mstfozkan/System-Control-Unit/ELEKTRONIK/BOM/PumpSystem BOM LIST.xlsx

Quantity | Designator | Description | Manufacturer Part Number | Fitted
51 | C1, C2, C4, C6, C7, C8, C9, C10, C11, C16, C17, C18, C19, C20, C21, C24, C25, C26, C51, C52, C53, C54, C55, C56, C57, C58, C59, C67, C68, C70, C71, C73, C75, C77, C79, C80, C83, C84, C85, C87, C88, C90, C91, C92, C93, C94, C95, C102, C112, C125, C126 | CAP CER 0.1UF 50V X7R 0603 | C1608X7R1H104K080AA | Fitted
4 | C3, C5, C32, C33 | CAP CER 4.7UF 100V X7S 1210 | HMK325C7475KM-PE | Fitted
2 | C12, C13 | CAP CER 12PF 50V C0G/NP0 0603 | CL10C120JB8NNNC | Fitted
6 | C14, C15, C22, C23, C38, C39 | CAP CER 22UF 25V X7R 1210 | CL32B226KAJNNNE | Fitted
2 | C27, C124 | CAP CER 22PF 50V C0G/NP0 0603 | CL10C220JB8NNNC | Fitted
4 | C28, C29, C122, C123 | CAP CER 0.022UF 50V X7R 0603L | CC0603KRX7R9BB223 | Fitted
5 | C30, C31, C37, C40, C41 | CAP CER 2.2UF 100V X7R 1210 | CL32B225KCJSNNE | Fitted
1 | C34 | CAP ALUM 100UF 20% 50V SMD | UUD1H101MNL1GS | Fitted
4 | C35, C36, C60, C64 | CAP CER 10UF 50V X7R 1210 | CL32B106KBJNNNE | Fitted
1 | C42 | CAP CER 3300PF 100V X7R 0603 | CGA3E2X7R2A332K080AA | Fitted
8 | C43, C44, C45, C46, C47, C48, C49, C50 | CAP CER 10UF 16V X6S 0603 | GRM188C81C106MA73D | Fitted
2 | C61, C65 | CAP CER 1UF 100V X7R 1206 | CL31B105KCHNNNE | Fitted
8 | C62, C63, C69, C74, C76, C78, C86, C89 | CAP CER 1UF 50V X7R 0603 | CC0603KRX7R9BB105 | Fitted
24 | C66, C72, C81, C82, C100, C101, C103, C104, C105, C106, C107, C108, C109, C110, C111, C113, C114, C115, C116, C117, C118, C119, C120, C121 | CAP CER 10000PF 100V X7R 0603 | C1608X7R2A103M080AA | Fitted
4 | C96, C97, C98, C99 | CAP CER 150PF 100V C0G/NP0 0603 | C0603C151J1GACTU | Fitted
1 | CMC1 | CMC 2.5A 2LN 1 KOHM SMD | DLW5BTM102TQ2L | Fitted
4 | D1, D3, D8, D9 | LED GREEN CLEAR 0603 SMD | LTST-C191KGKT | Fitted
2 | D2, D4 | LED RED CLEAR 0603 SMD | 150060RS75000 | Fitted
1 | D5 | DIODE ZENER 10V 500MW SOD123 | BZT52C10-7-F | Fitted
2 | D6, D7 | DIODE GEN PURP 100V 150MA SOD123 | 1N4148W-TP | Fitted
8 | FB1, FB2, FB3, FB5, FB6, FB7, FB13, FB14 | FERRITE BEAD 330 OHM 0603 1LN | BLM18PG331SN1D | Fitted
1 | FB4 | FERRITE BEAD 120 OHM 1206 1LN | HI1206P121R-10 | Fitted
4 | FB8, FB9, FB10, FB11 | FERRITE BEAD 600 OHM 0603 1LN | BLM18KG601SN1D | Fitted
1 | FB12 | FERRITE BEAD 300 OHM 1206 1LN | 742792121 | Fitted
4 | J1, J2, J10, J11 | CONN RCPT 6POS 0.1 TIN PCB | M20-7820646 | Fitted
2 | J3, J4 | WR-DSUB FEMALE ANGLED PCB CONNEC | 618009211821 | Fitted
2 | J5, J8 | TERM BLK 8P SIDE ENT 2.54MM SMD | 14010813102000 | Fitted
1 | J6 | CONN HEADER VERT 20POS 2.54MM | 302-S201 | Fitted
2 | J7, J9 | CONN PLUG FMALE 4POS GOLD SOLDER | T4145515041-001 | Fitted
1 | J12 | TERM BLK 2P SIDE ENT 2.54MM SMD | 14010213102000 | Fitted
2 | L1, L2 | FIXED IND 2.2UH 2.1A 106 MOHM | 74479299222 | Fitted
1 | L3 | FIXED IND 4.7UH 5.5A 34.5MOHM | 74438367047 | Fitted
1 | Q1 | P-channel MOSFET SOT-223 | MCT06P10-TP | Fitted
3 | Q2, Q3, Q4 | TRANS NPN 80V 0.5A SOT23 | MMBTA06LT1G | Fitted
11 | R1, R2, R14, R16, R27, R37, R38, R40, R42, R71, R72 | RES SMD 10K OHM 1% 1/10W 0603 | RC0603FR-0710KL | Fitted
6 | R3, R4, R6, R7, R63, R64 | RES 249 OHM 1% 1/10W 0603 | RMCF0603FT249R | Fitted
10 | R5, R8, R15, R17, R20, R23, R61, R62, R65, R66 | RES SMD 0 OHM 1/10W JUMP 0603 | RC0603JR-070RL | Fitted
1 | R9 | RES 100K OHM 1% 1/10W 0603 | RMCF0603FT100K | Fitted
1 | R10 | RES 200K OHM 1% 1/10W 0603 | RMCF0603FT200K | Fitted
3 | R11, R24, R41 | RES 250 OHM 0.01% 1/10W 0603 | RNCF0603TKY250R | Fitted
1 | R12 | RES SMD 22K OHM 1% 1/8W 0603 | MCT06030C2202FP500 | Fitted
3 | R13, R44, R46 | RES 69.8K OHM 1% 1/10W 0603 | RMCF0603FT69K8 | Fitted
3 | R18, R33, R35 | RES SMD 100 OHM 1% 1/8W 0603 | RNCP0603FTD100R | Fitted
9 | R19, R21, R26, R28, R31, R32, R34, R69, R70 | RES SMD 1K OHM 5% 1/10W 0603 | RC0603JR-071KL | Fitted
4 | R22, R39, R43, R45 | RES SMD 5.11KOHM 0.1% 1/10W 0603 | ERA-3AEB5111V | Fitted
1 | R25 | RES 27.4K OHM 1% 1/10W 0603 | RMCF0603FT27K4 | Fitted
2 | R29, R36 | RES SMD 470 OHM 5% 1/10W 0603 | RC0603JR-07470RL | Fitted
1 | R30 | RES SMD 0 OHM 1/10W JUMP 0603 | RC0603JR-070RL | Fitted
8 | R47, R48, R49, R50, R51, R52, R53, R54 | RES SMD 75 OHM 1% 1/10W 0603 | RMCF0603FT75R0 | Fitted
4 | R55, R56, R57, R58 | RES 51 OHM 1% 1/10W 0603 | RMCF0603FT51R0 | Fitted
2 | R59, R60 | RES SMD 100K OHM 5% 1/10W 0603 | RC0603JR-10100KL | Fitted
2 | R67, R68 | RES SMD 330 OHM 5% 1/10W 0603 | RC0603JR-07330RL | Fitted
2 | SW1, SW2 | SWITCH SLIDE DPDT 100MA 12V | AYZ0202AGRLC | Fitted
2 | SW3, SW4 | SWITCH TACTILE SPST-NO 0.05A 24V | FSM4JSMA | Fitted
4 | T1, T2, T3, T4 | WE-RJ45 LAN INTEGRATED RJ45 TRANS | 74980104400 | Fitted
2 | TVS1, TVS30 | DIODE TVS 33VWM 53.3VC SMB | SMBJ33CA | Fitted
4 | TVS2, TVS4, TVS5, TVS7 | TVS DIODE 15V 24.4V DO214AC | SMAJ15CA | Fitted
2 | TVS3, TVS6 | TVS DIODE 15V 44V SOT23 | PESD15VL2BT,215 | Fitted
20 | TVS8, TVS9, TVS11, TVS12, TVS13, TVS14, TVS15, TVS16, TVS17, TVS18, TVS19, TVS21, TVS22, TVS23, TVS24, TVS25, TVS26, TVS27, TVS28, TVS29 | TVS DIODE 33V 53.3V DO214AC | SMAJ33CA | Fitted
8 | TVS10, TVS20, TVS31, TVS32, TVS33, TVS34, TVS35, TVS36 | TVS DIODE 5.5V 12.4V SC70-3 | TPD2E2U06QDCKRQ1 | Fitted
1 | U1 | IC MCU 32BIT 256KB FLASH 64LQFP | STM32F446RCT6TR | Fitted
1 | U2 | DCDC CONV HV BUCK SO-8EP | AP64350SP-13 | Fitted
2 | U3, U4 | IC REG LINEAR 3.3V 1.5A 8SO | AP7362A-33SP-13 | Fitted
1 | U5 | IC TRANSCEIVER FULL 2/2 16TSSOP | TRS3232ECPWR | Fitted
2 | U6, U7 | IC TRANSCEIVER 1/1 10VSON | TIOL111DMWR | Fitted
1 | U8 | IC OPAMP GP 2 CIRCUIT 8SOIC | LM2904BQDRQ1 | Fitted
1 | U9 | IC ADC 24BIT SIGMA-DELTA 32LFCSP | AD7124-8BCPZ | Fitted
1 | U10 | IC EEPROM 128K I2C 1MHZ 8SOIC | AT24C128C-SSHM-B | Fitted
1 | VR1 | VARISTOR 39V 80A 0805 | B72510E1250K62 | Fitted
1 | Y1 | CRYSTAL 16MHZ 12PF SMD | RH100-16.000-12-3050-EX | Fitted
1 | Y2 | XTAL OSC XO 2.4576MHZ CMOS SMD | SG-210STF 2.4576ML | Fitted
