mstfozkan/System-Control-Unit/DOKUMANLAR/Schematic.PDF

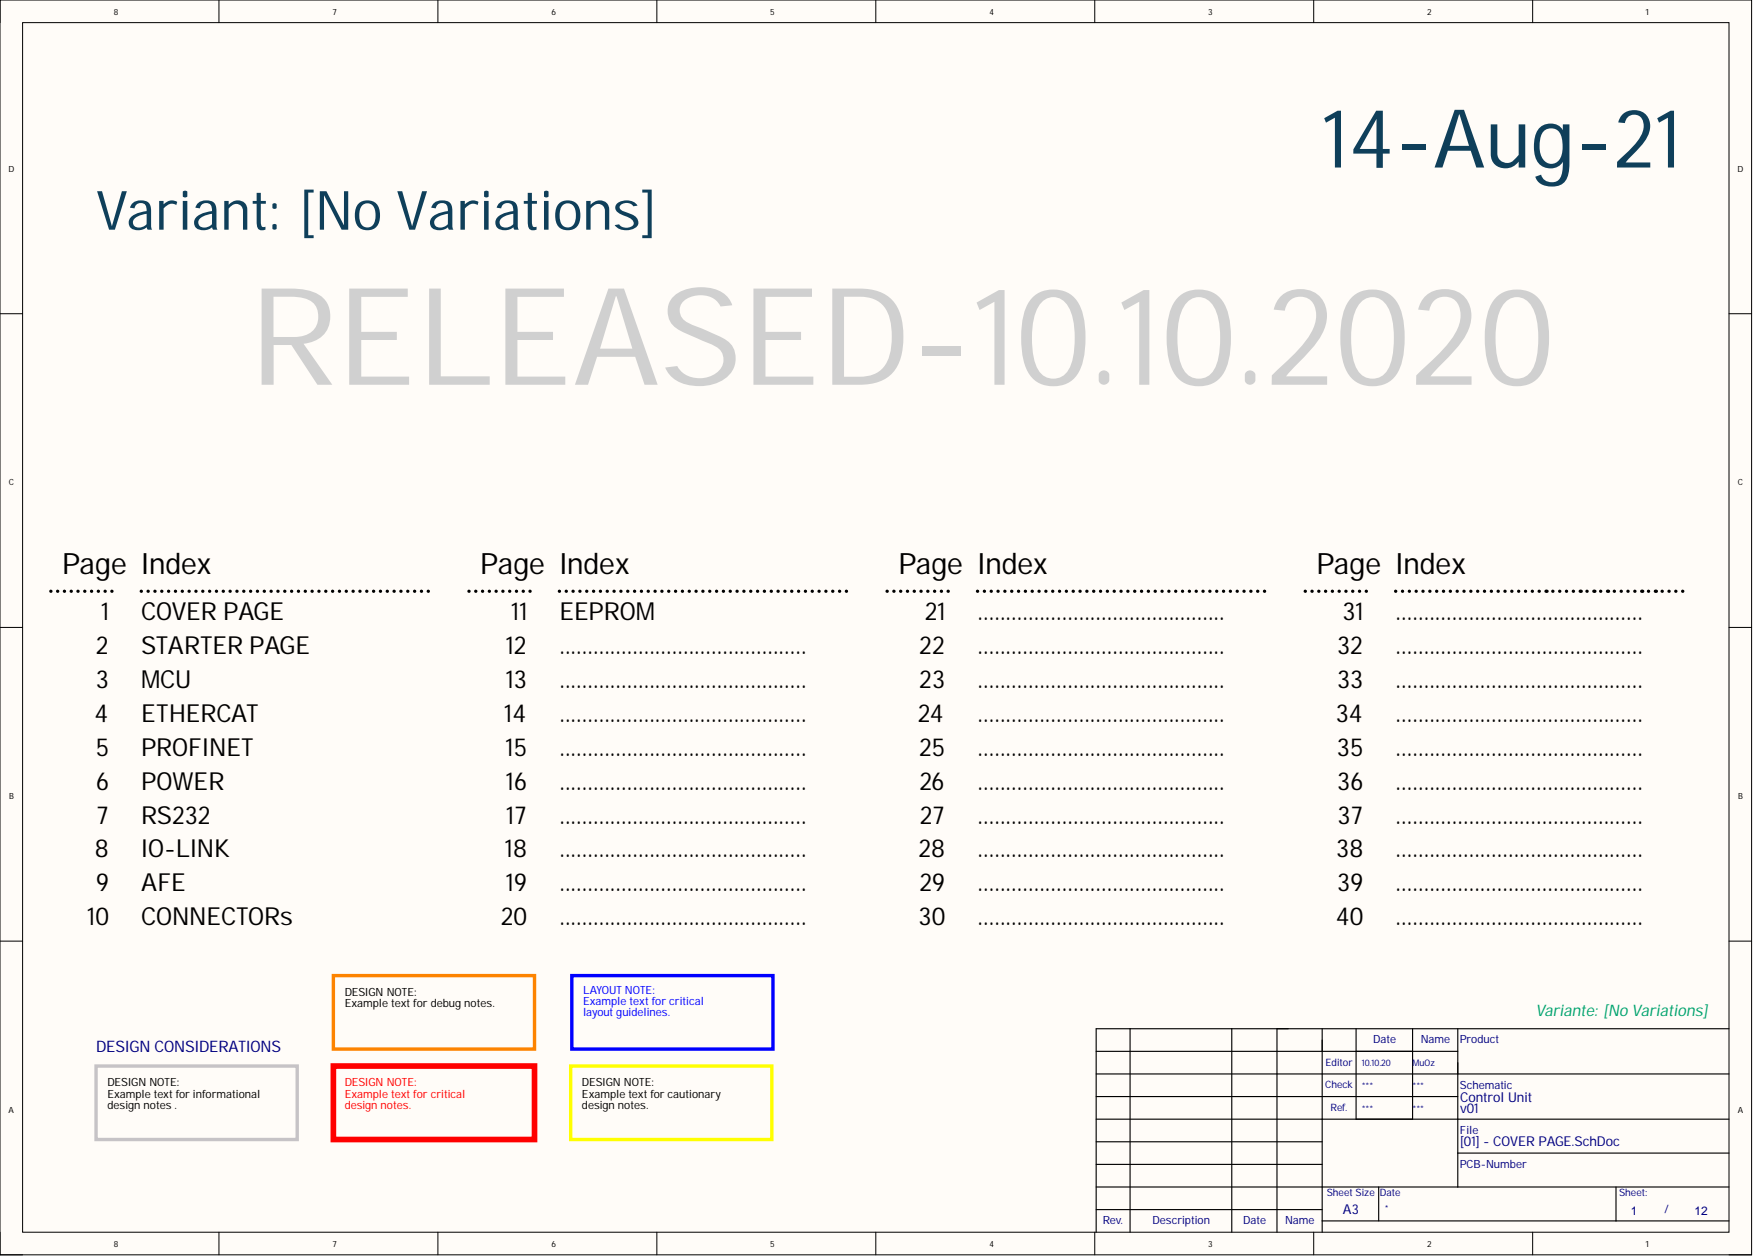
[picture p1: page 1]

DESIGN NOTE:
Example text for debug notes.

LAYOUT NOTE:
Example text for critical
layout guidelines.

Example text for informational
design notes .

design notes.

Example text for cautionary

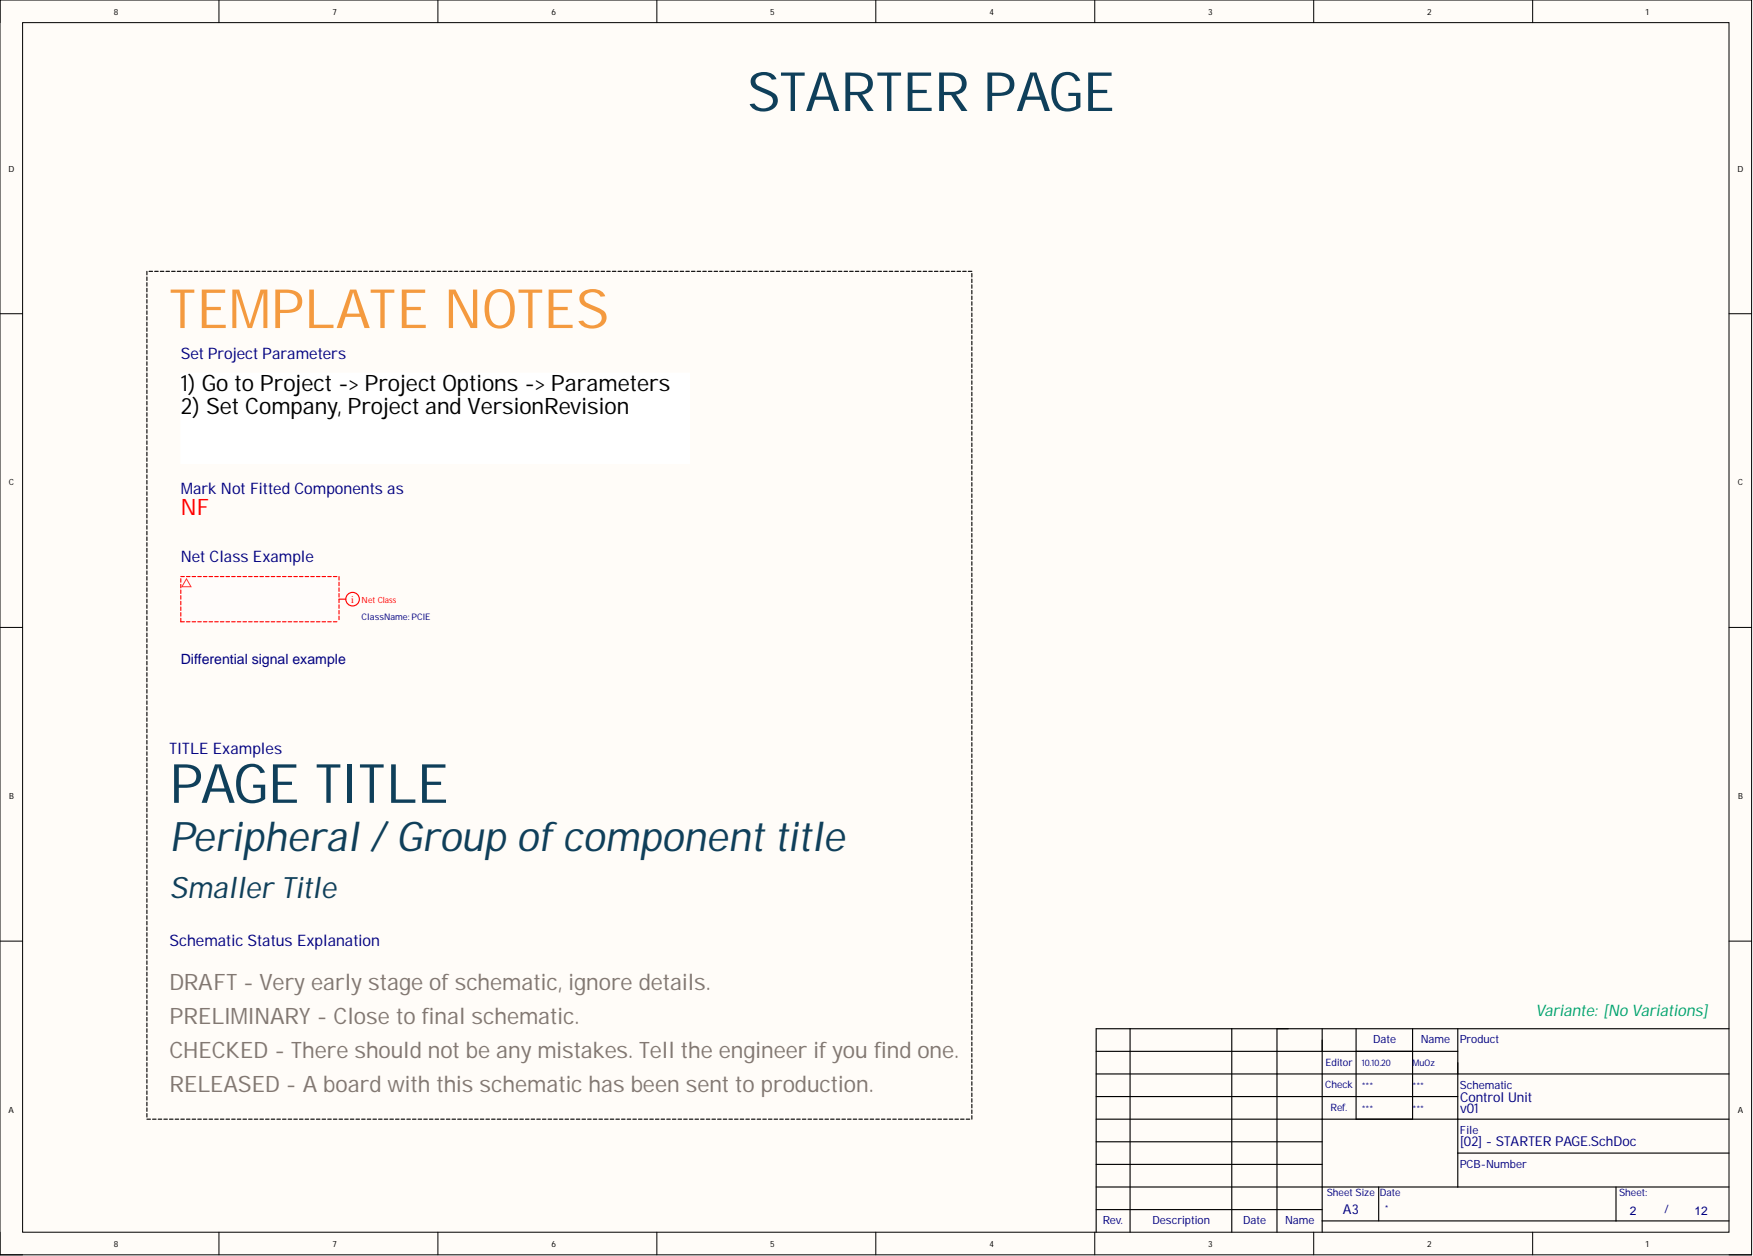
[picture p2: page 2]

Set Project Parameters
1) Go to Project -> Project Options -> Parameters
2) Set Company, Project and VersionRevision

Mark Not Fitted Components as

TITLE Examples
PAGE TITLE
Peripheral / Group of component title

Schematic Status Explanation
DRAFT - Very early stage of schematic, ignore details.
PRELIMINARY - Close to final schematic.
CHECKED - There should not be any mistakes. Tell the engineer if you find one.
RELEASED - A board with this schematic has been sent to production.

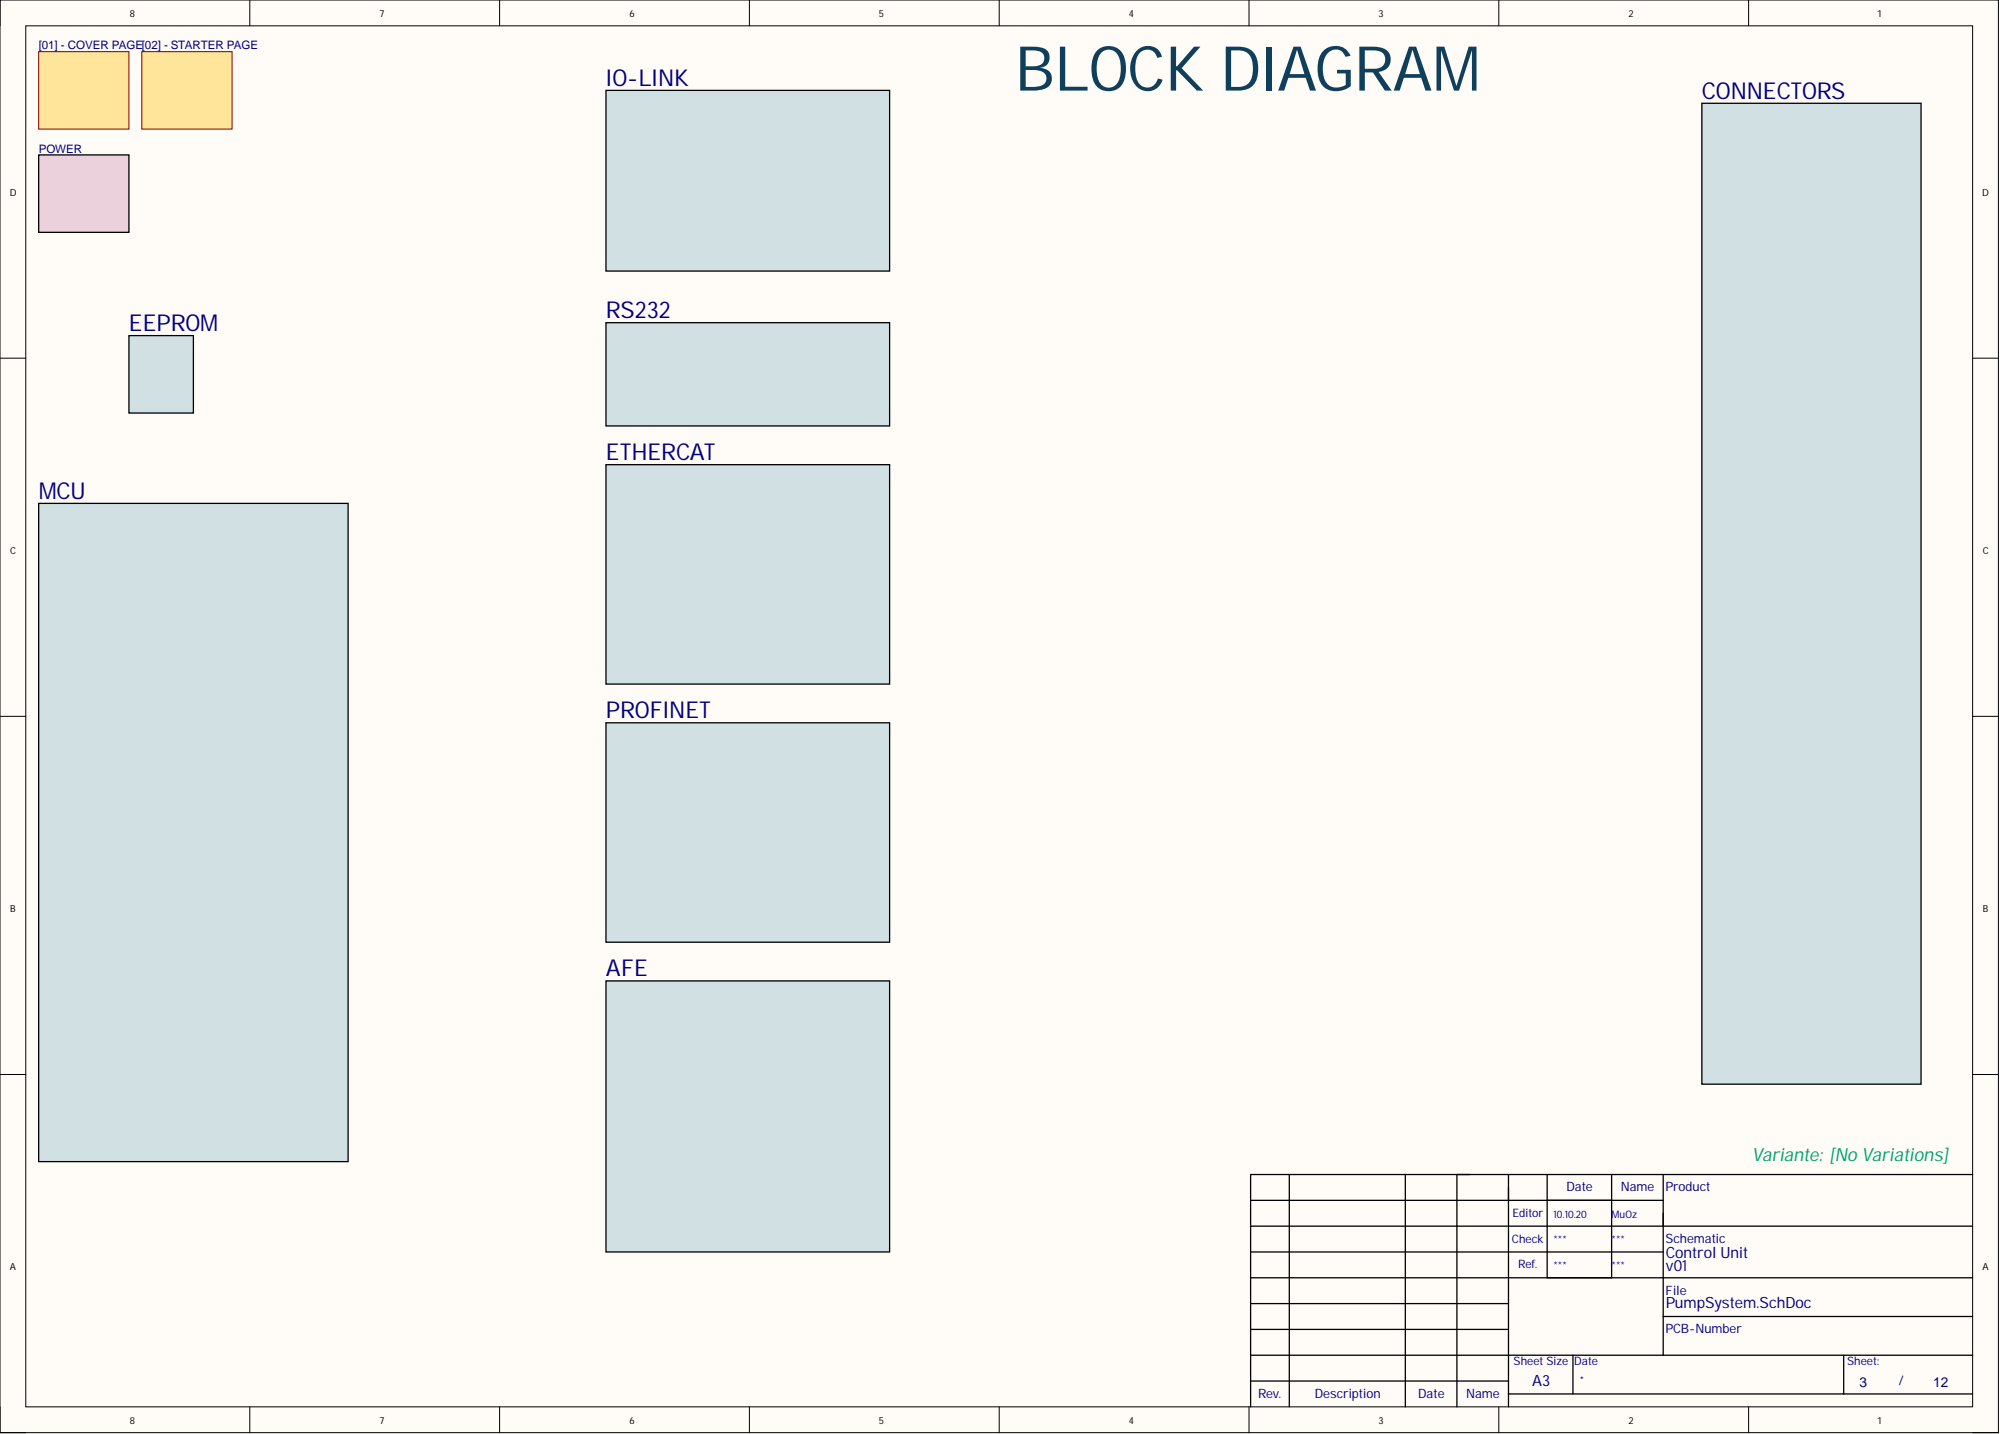
[picture p3: page 3]

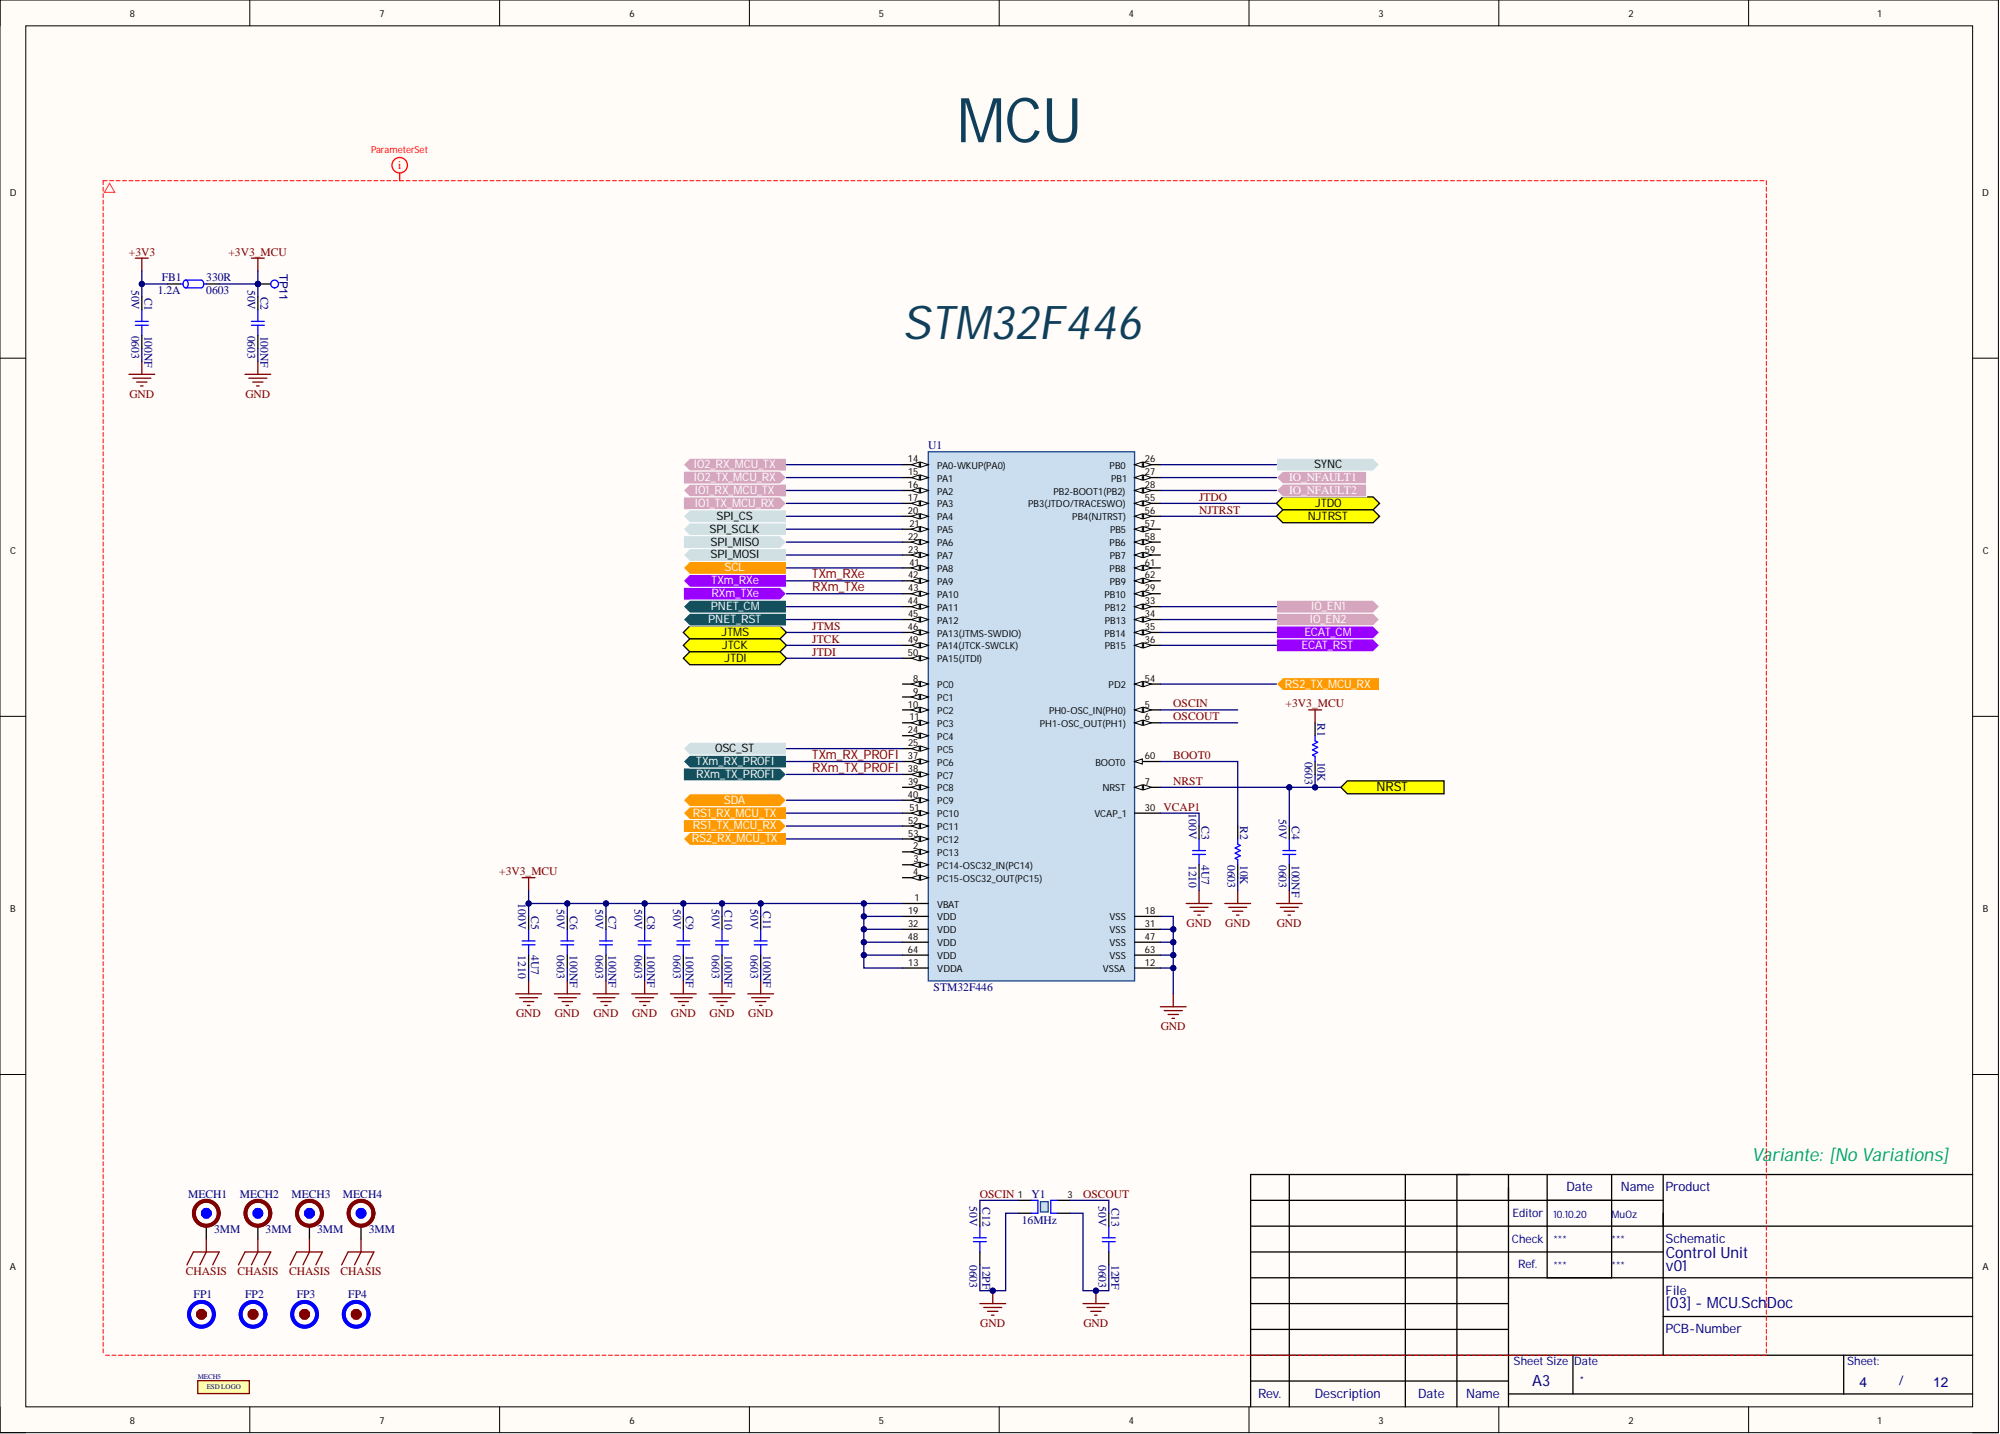
[picture p4: page 4]

CHASIS CHASIS

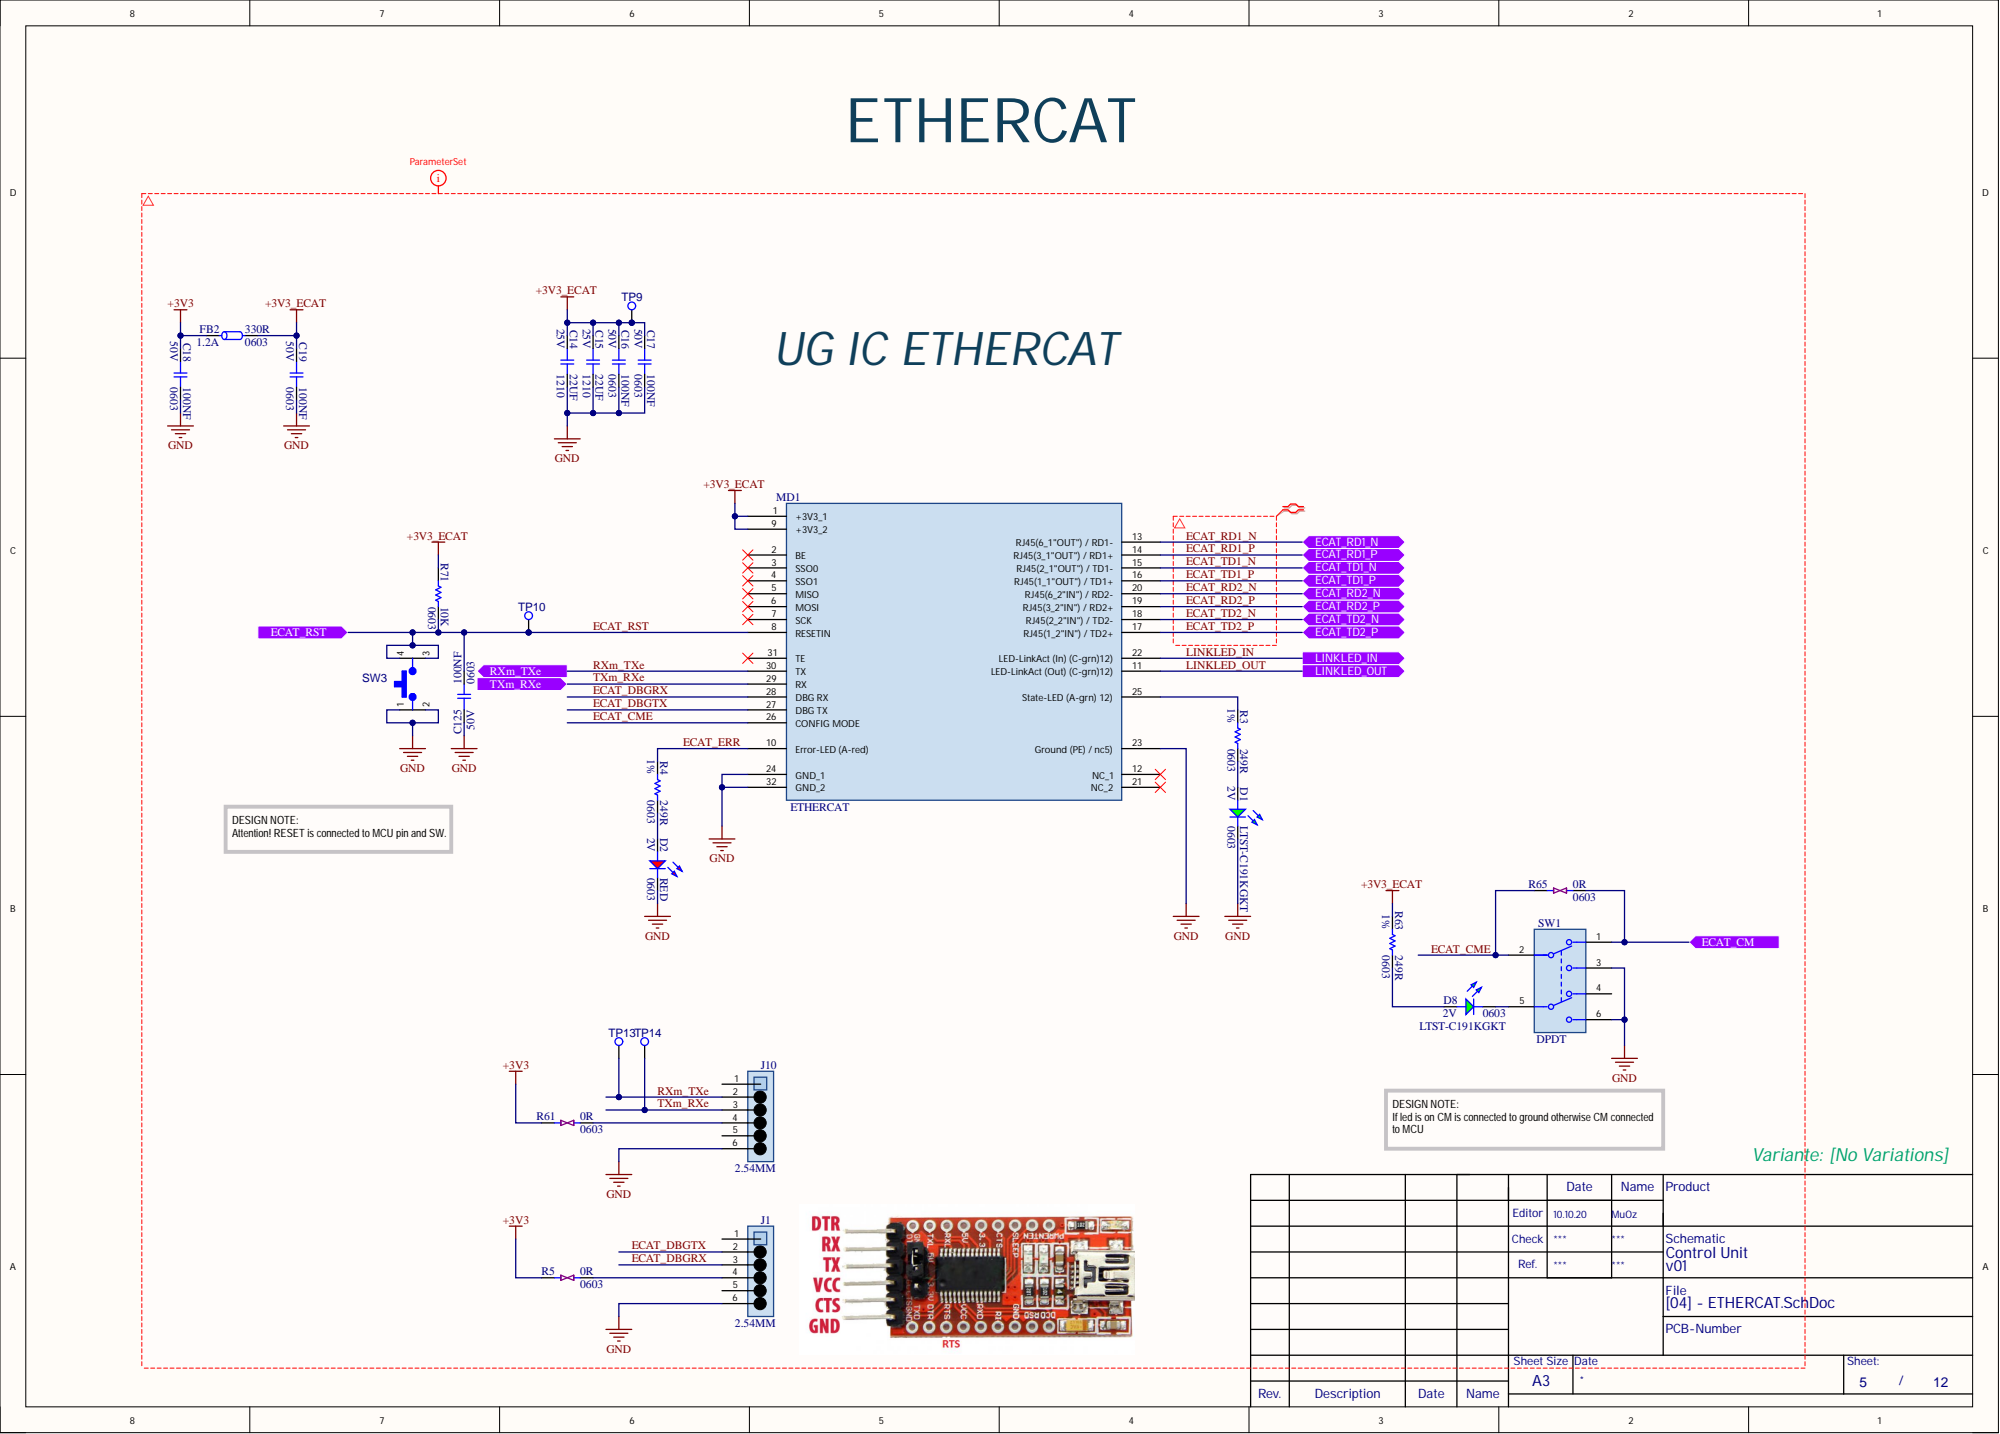
[picture p5: page 5]

DESIGN NOTE:
Attention! RESET is connected to MCU pin and SW.

If led is on CM is connected to ground otherwise CM connected
to MCU

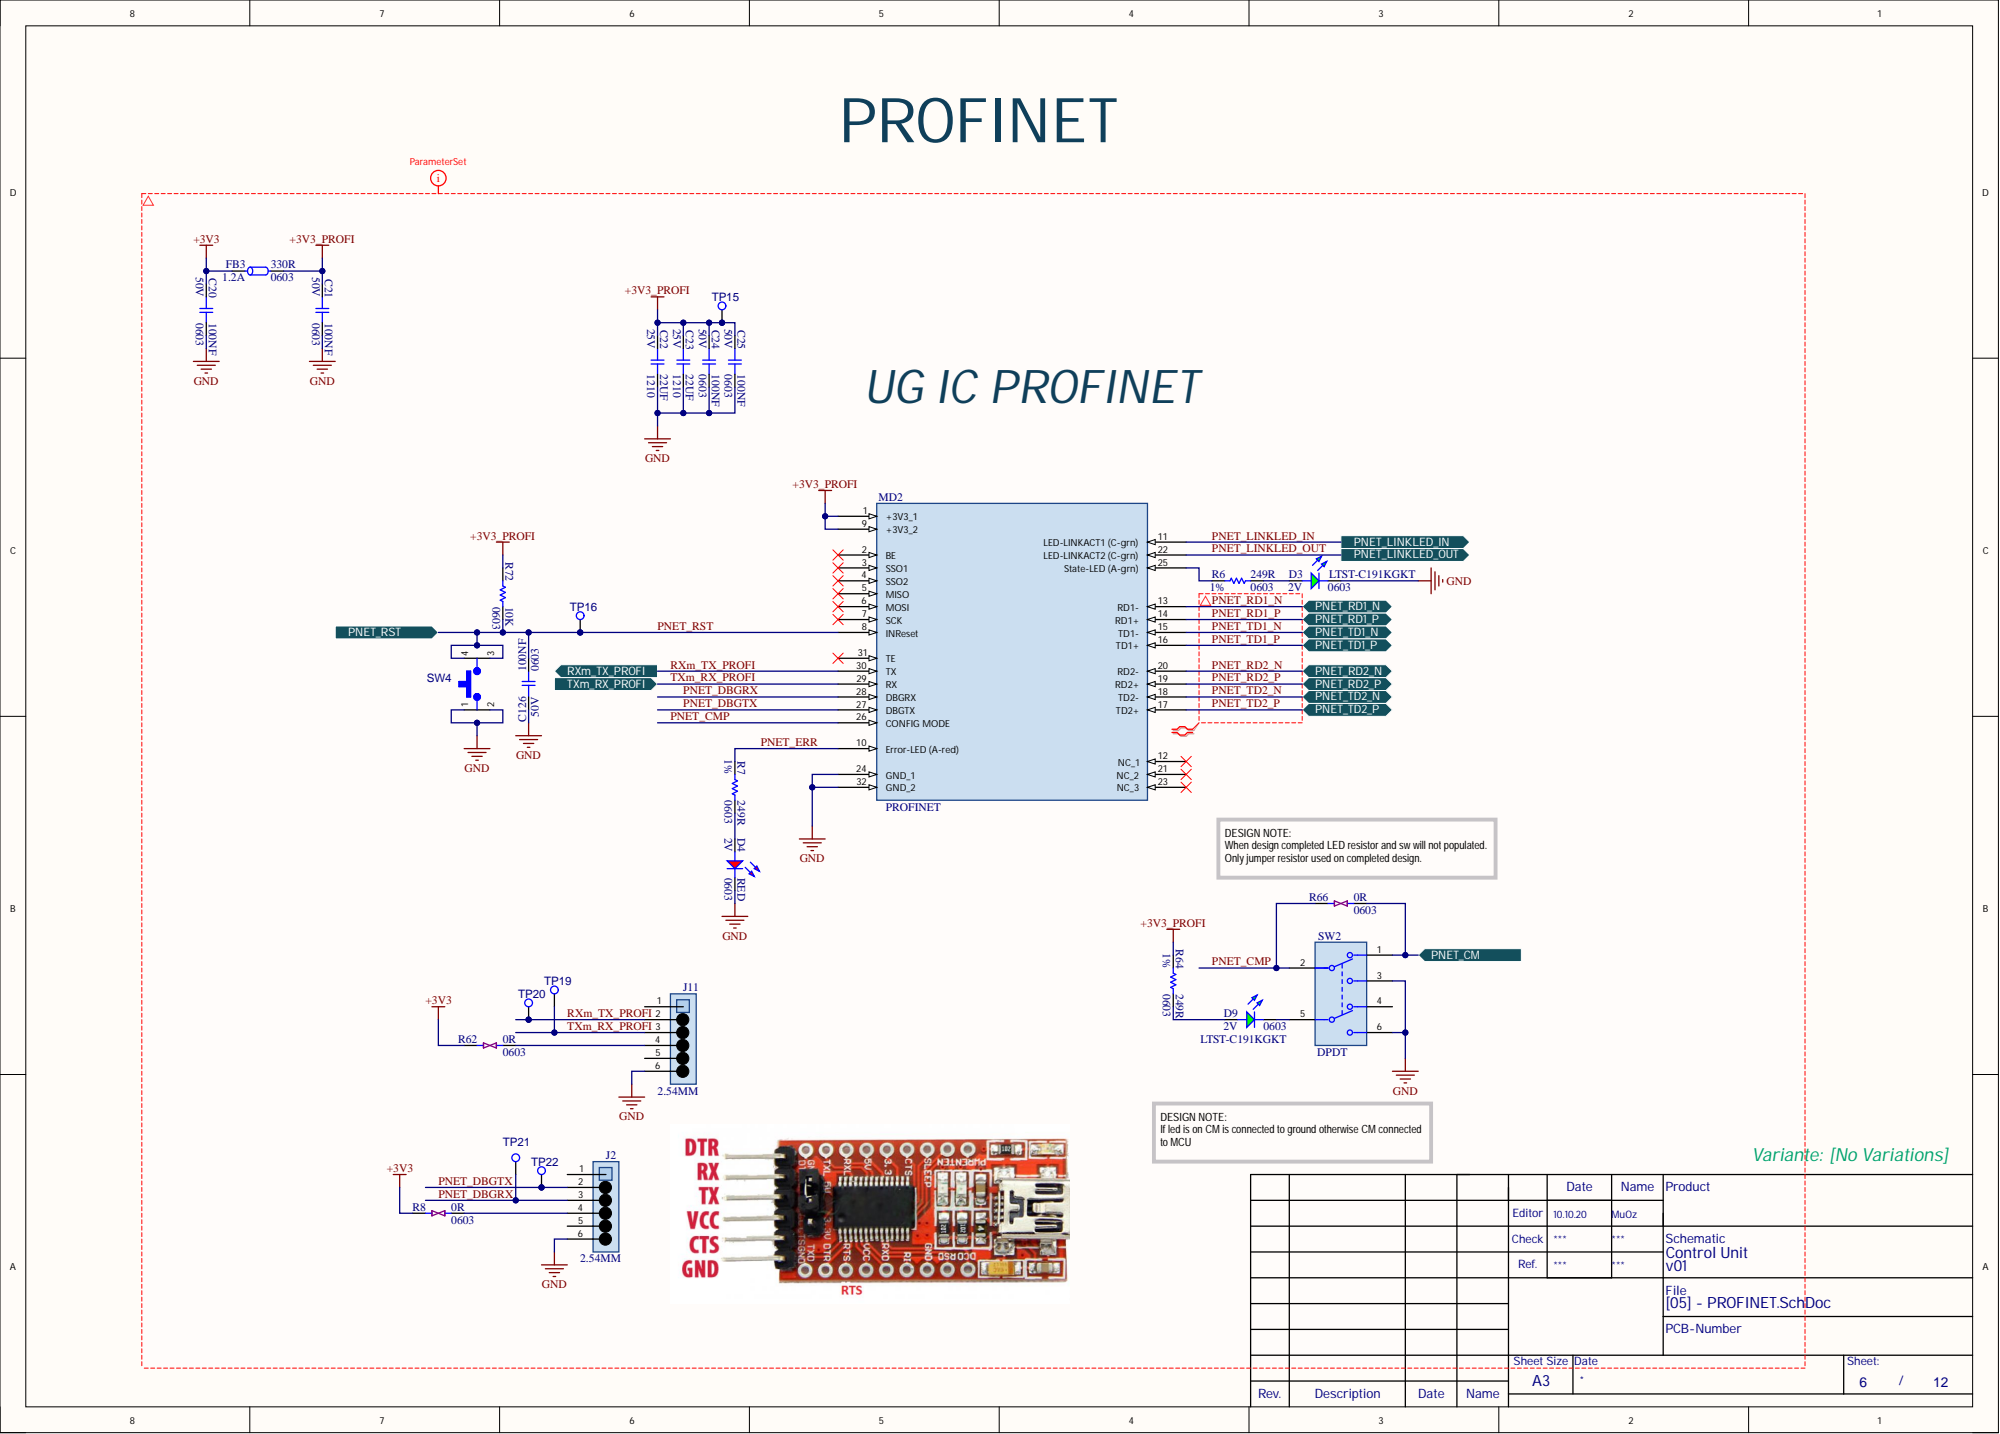
[picture p6: page 6]

DESIGN NOTE:
When design completed LED resistor and sw will not populated.
Only jumper resistor used on completed design.

If led is on CM is connected to ground otherwise CM connected
to MCU

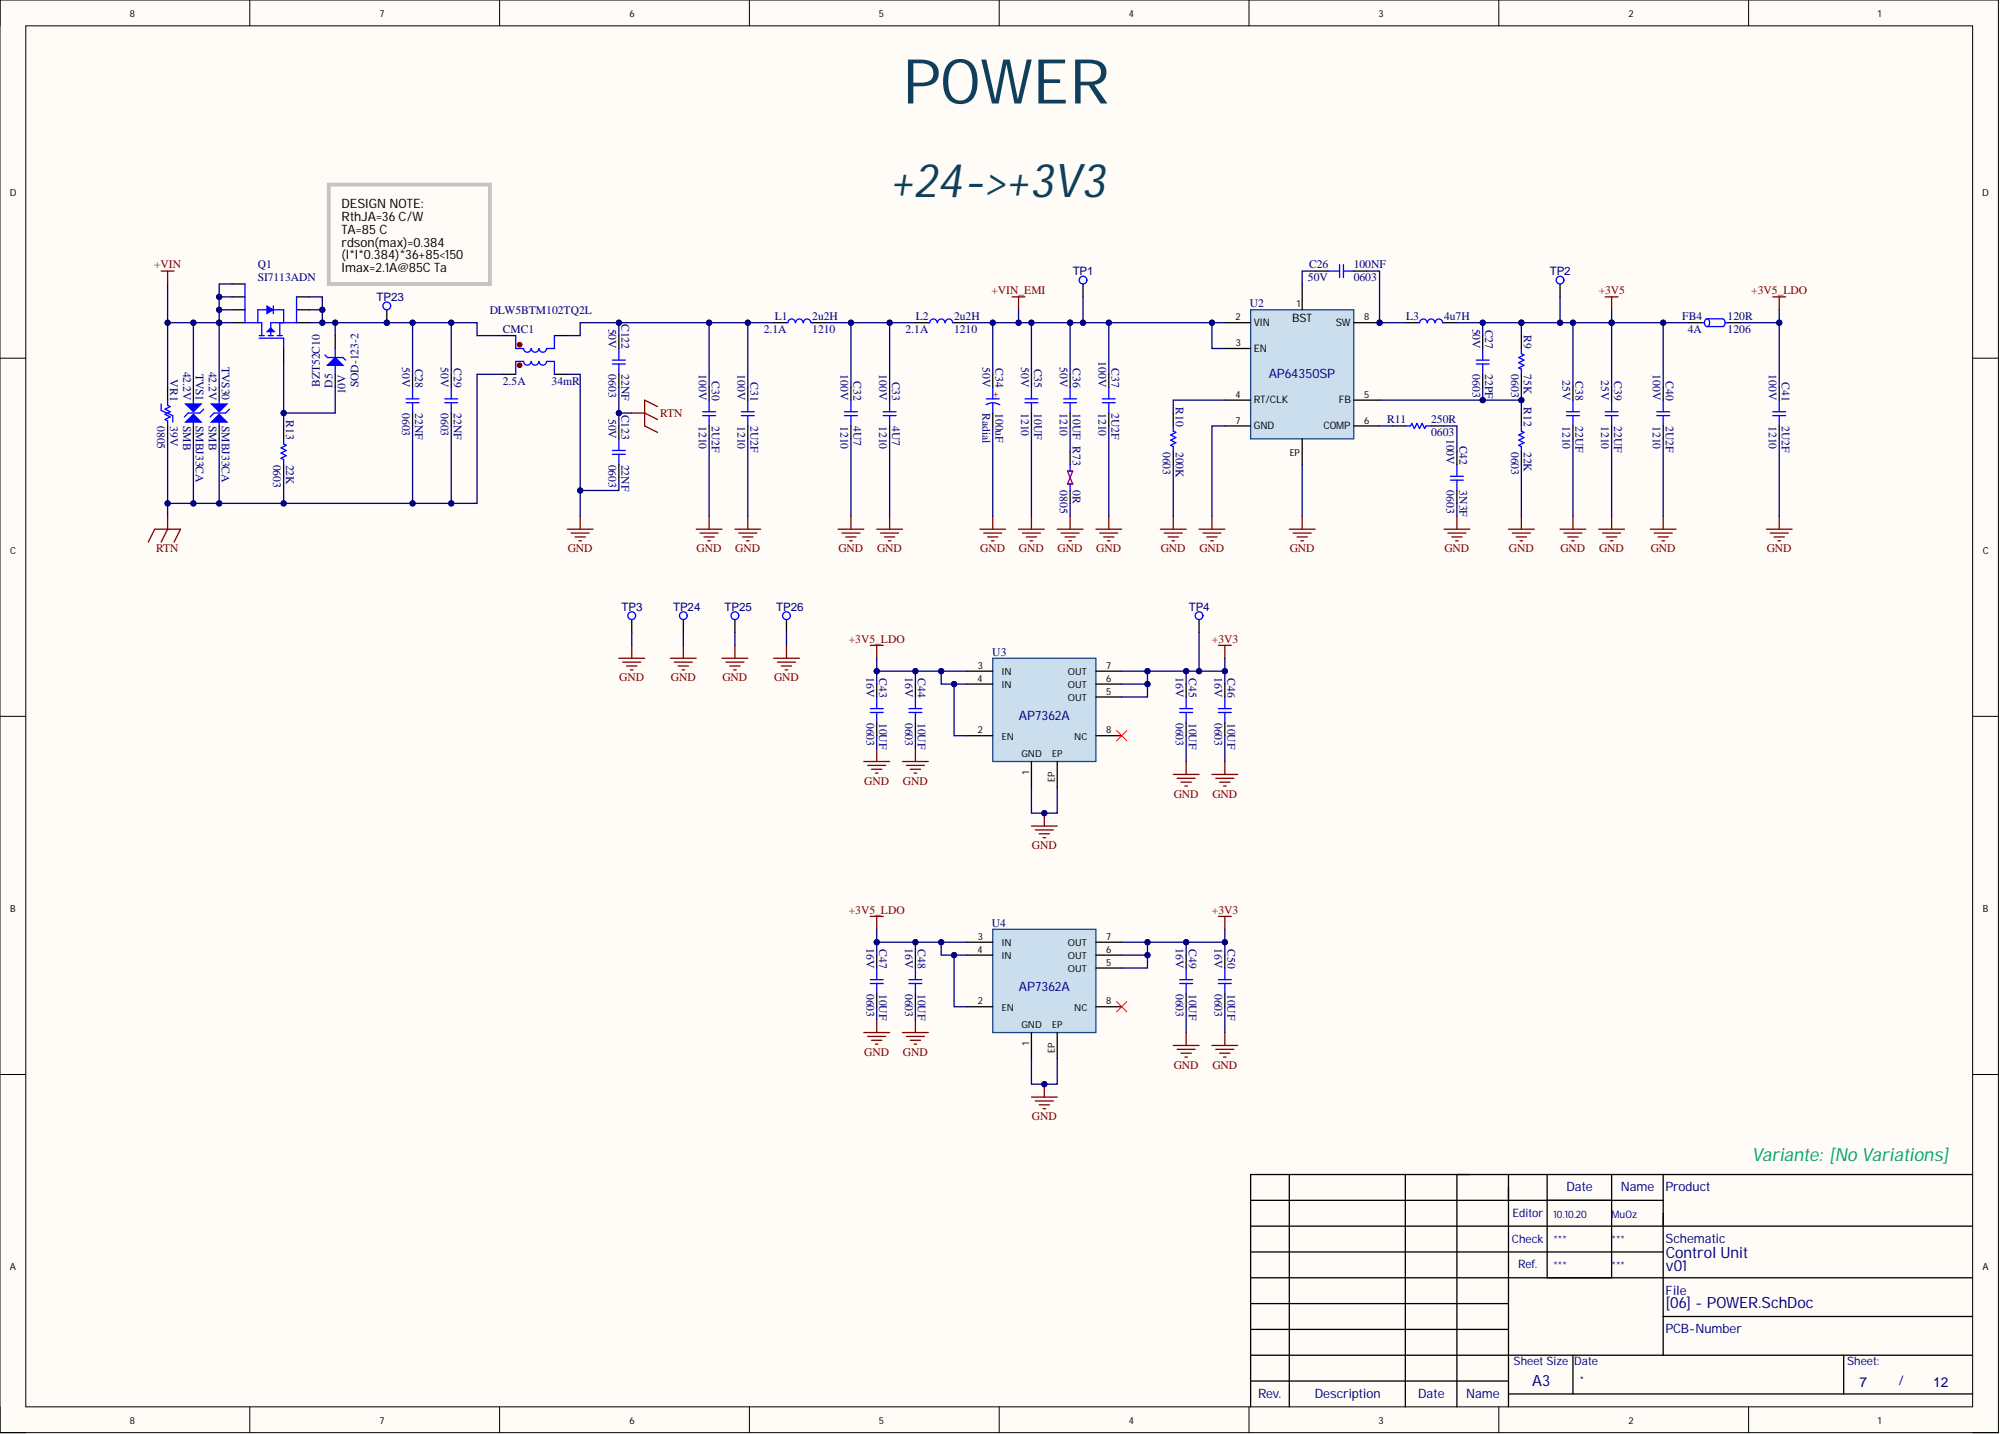
[picture p7: page 7]

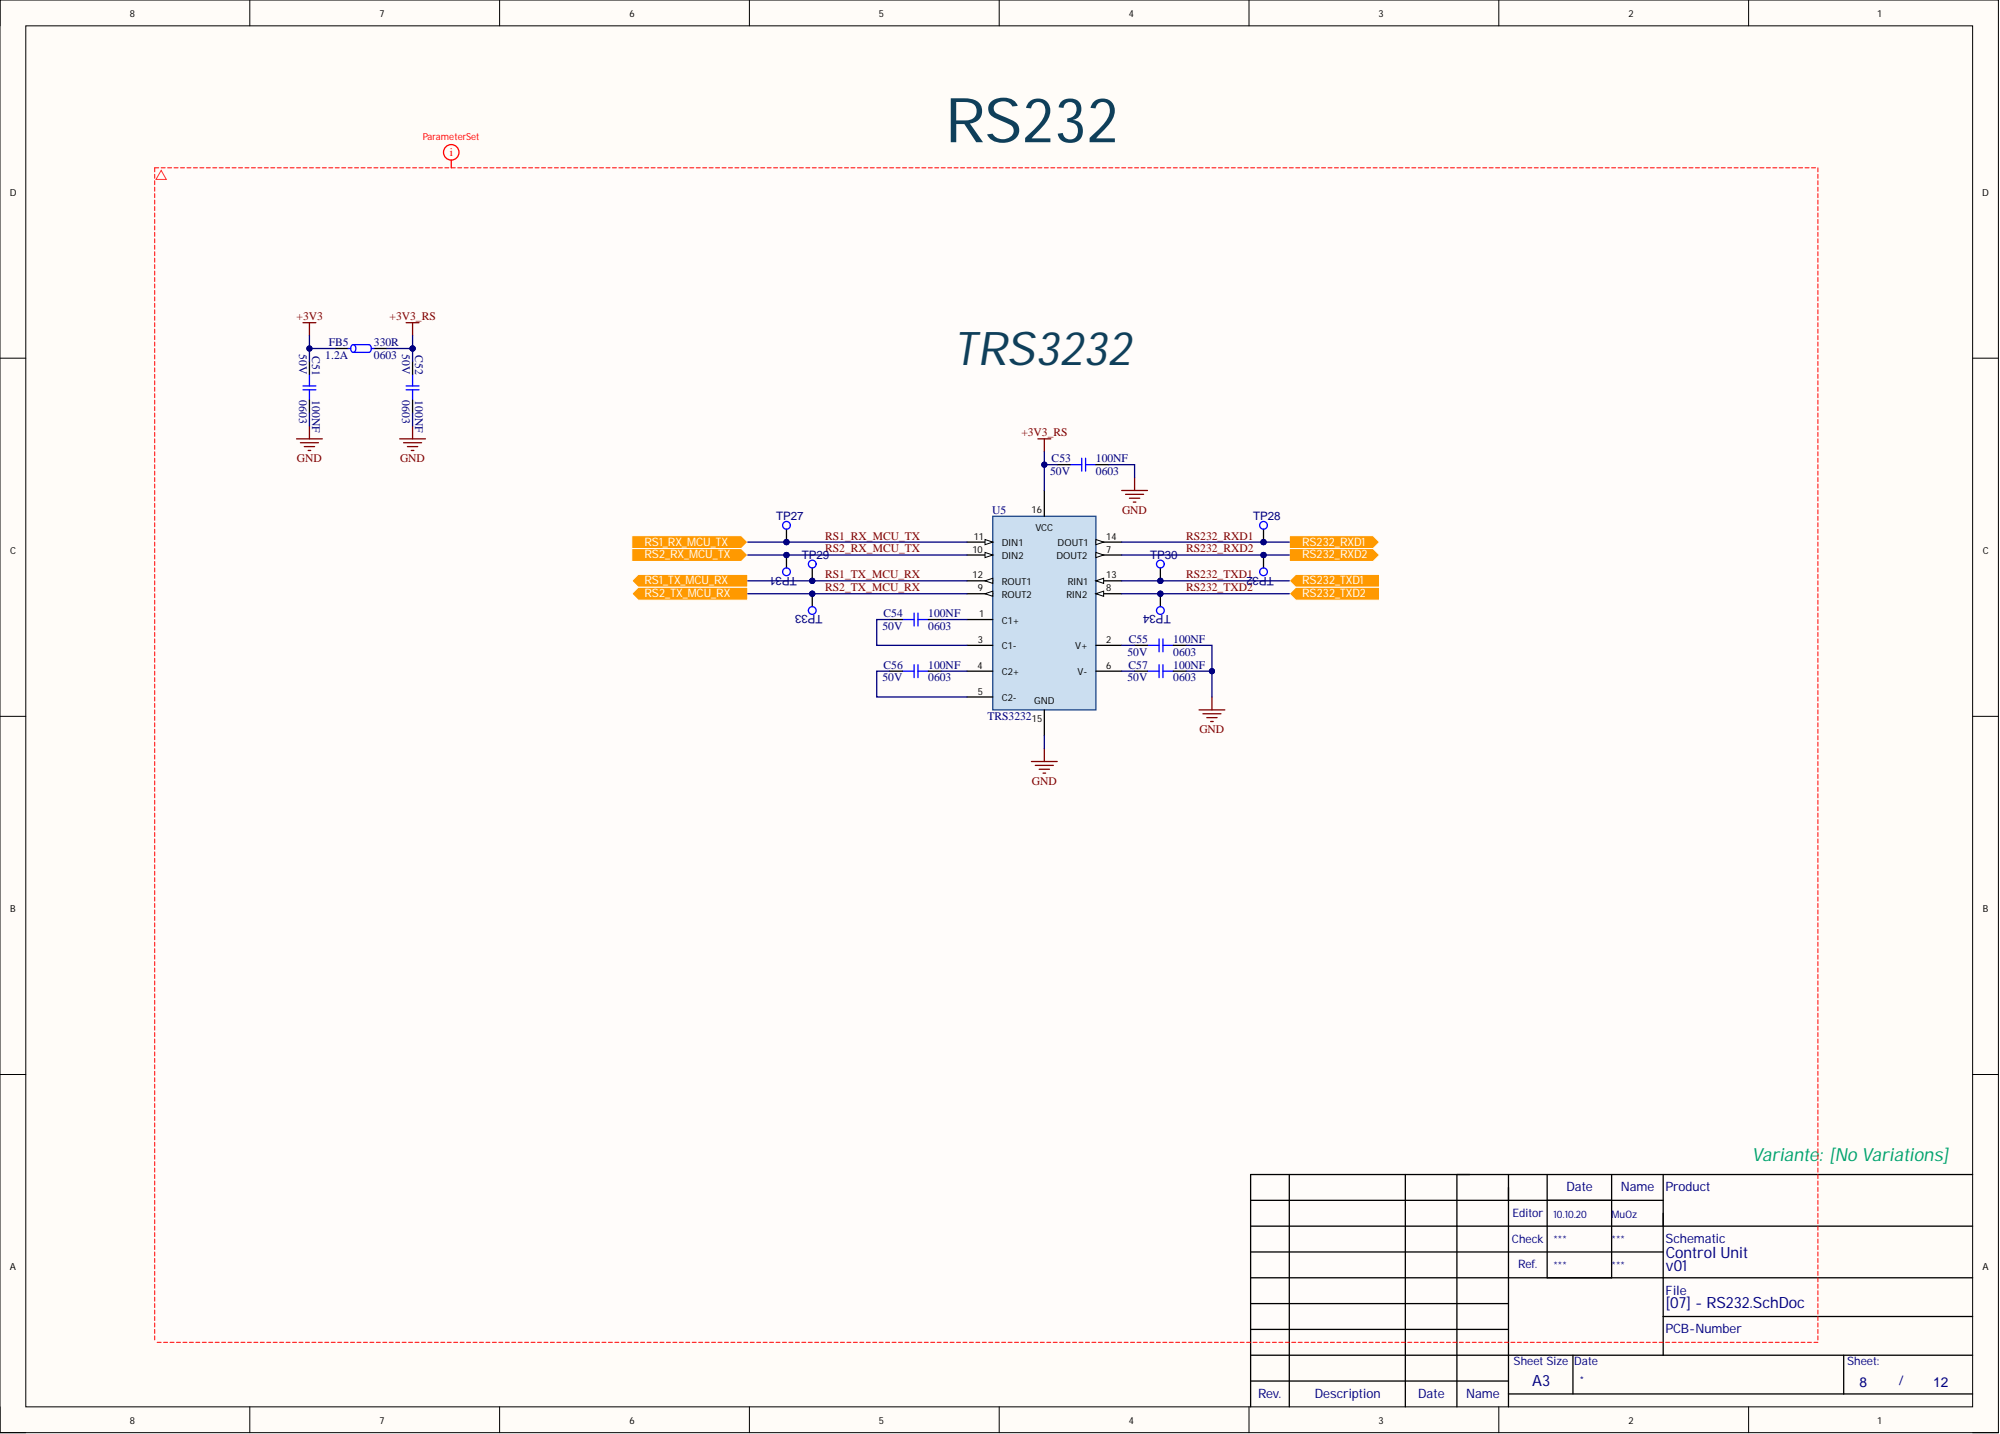
[picture p8: page 8]

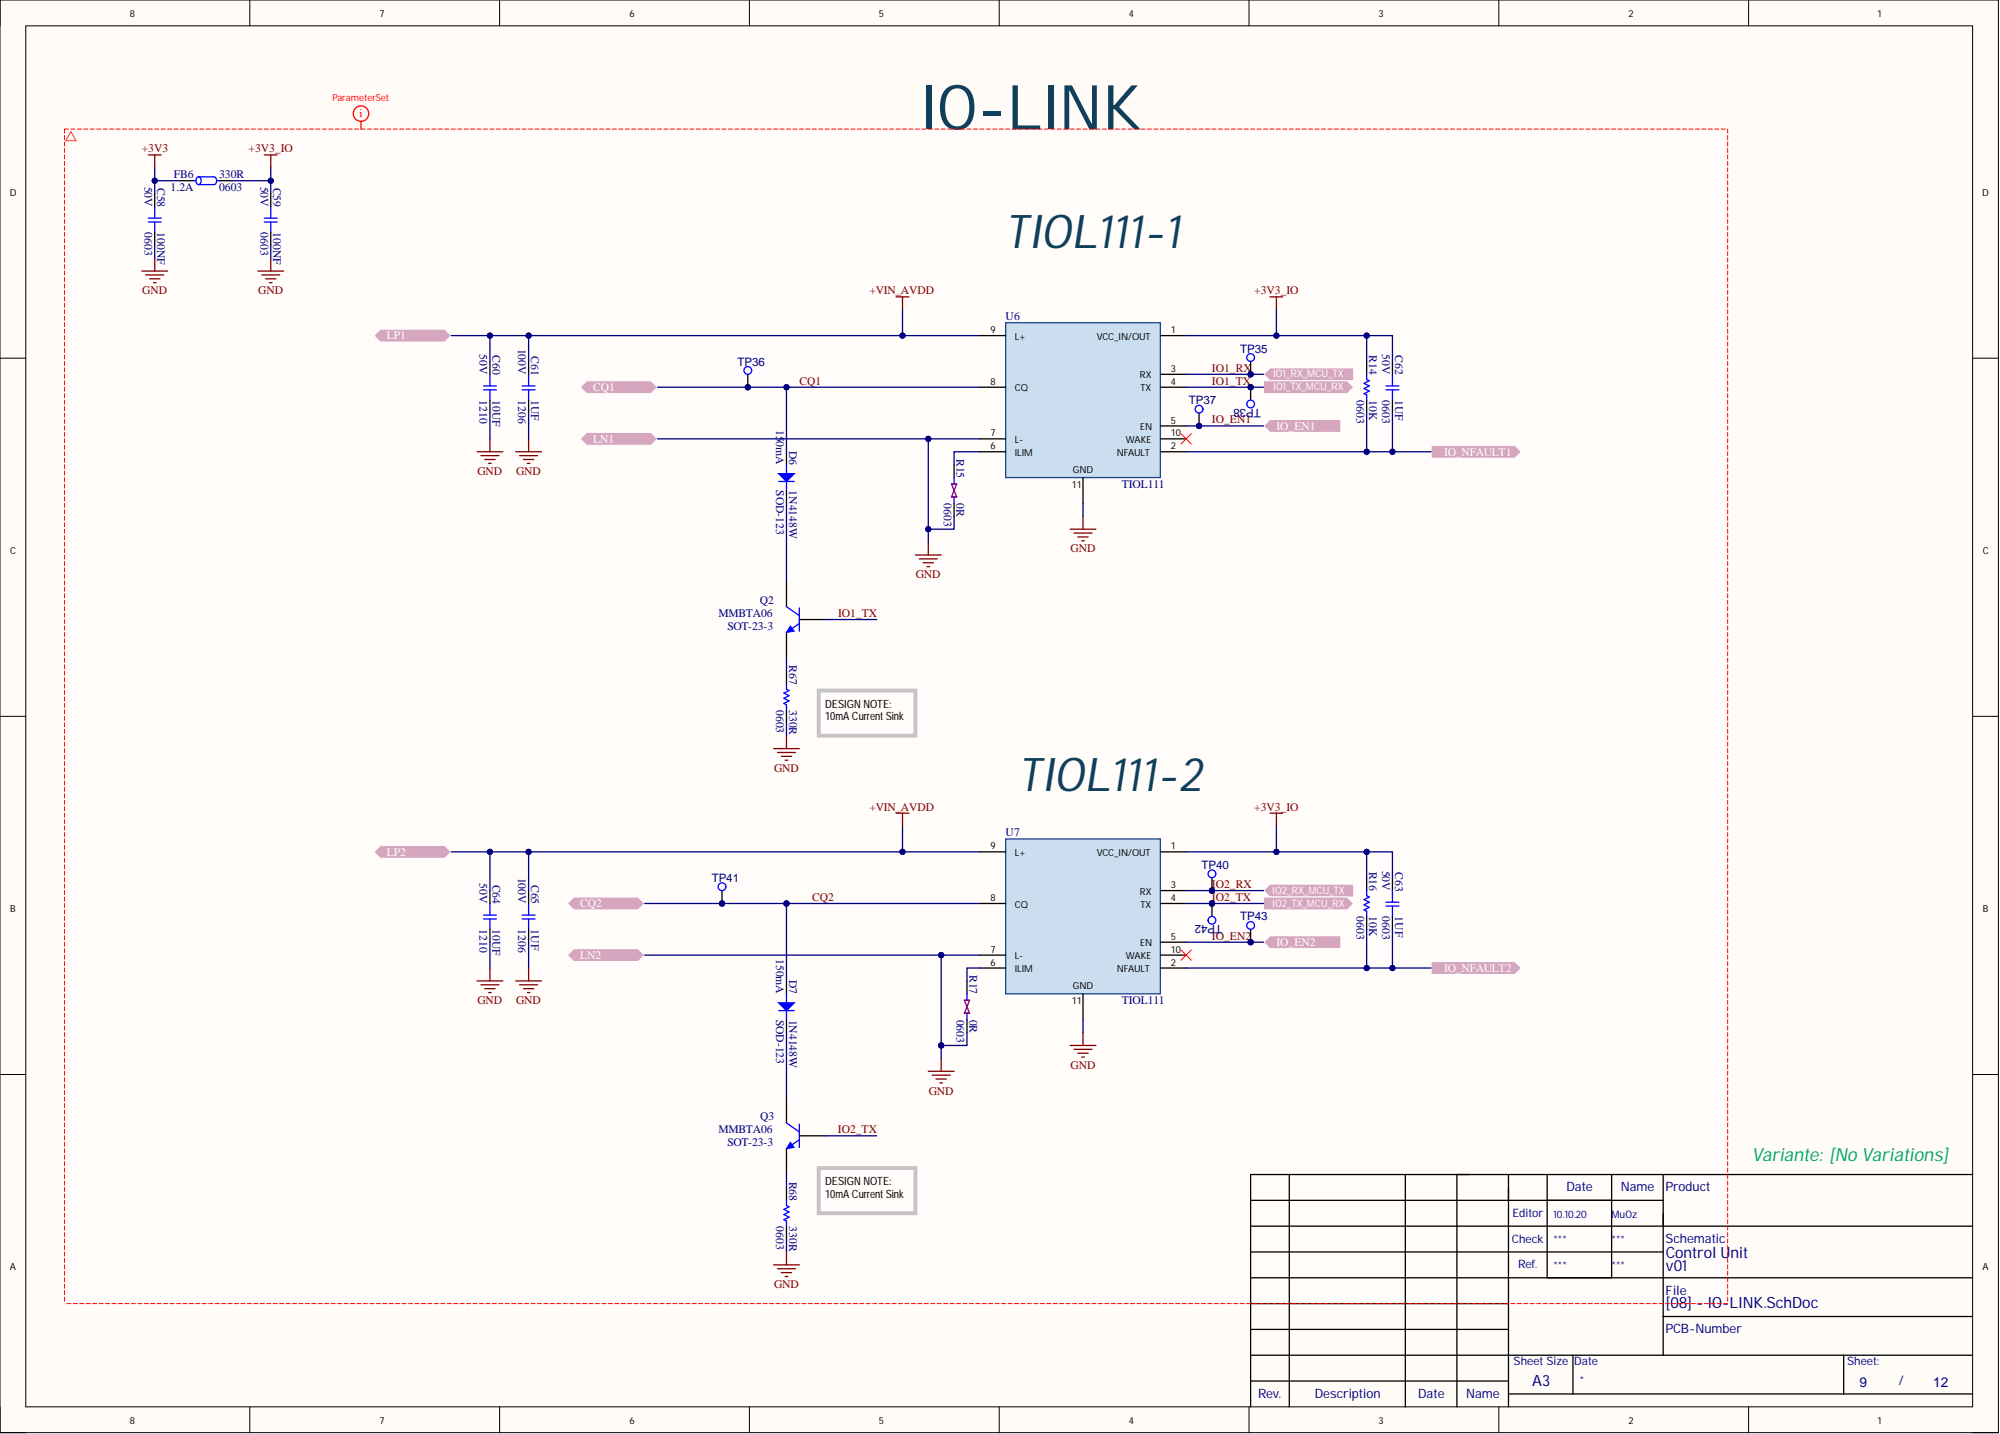
[picture p9: page 9]

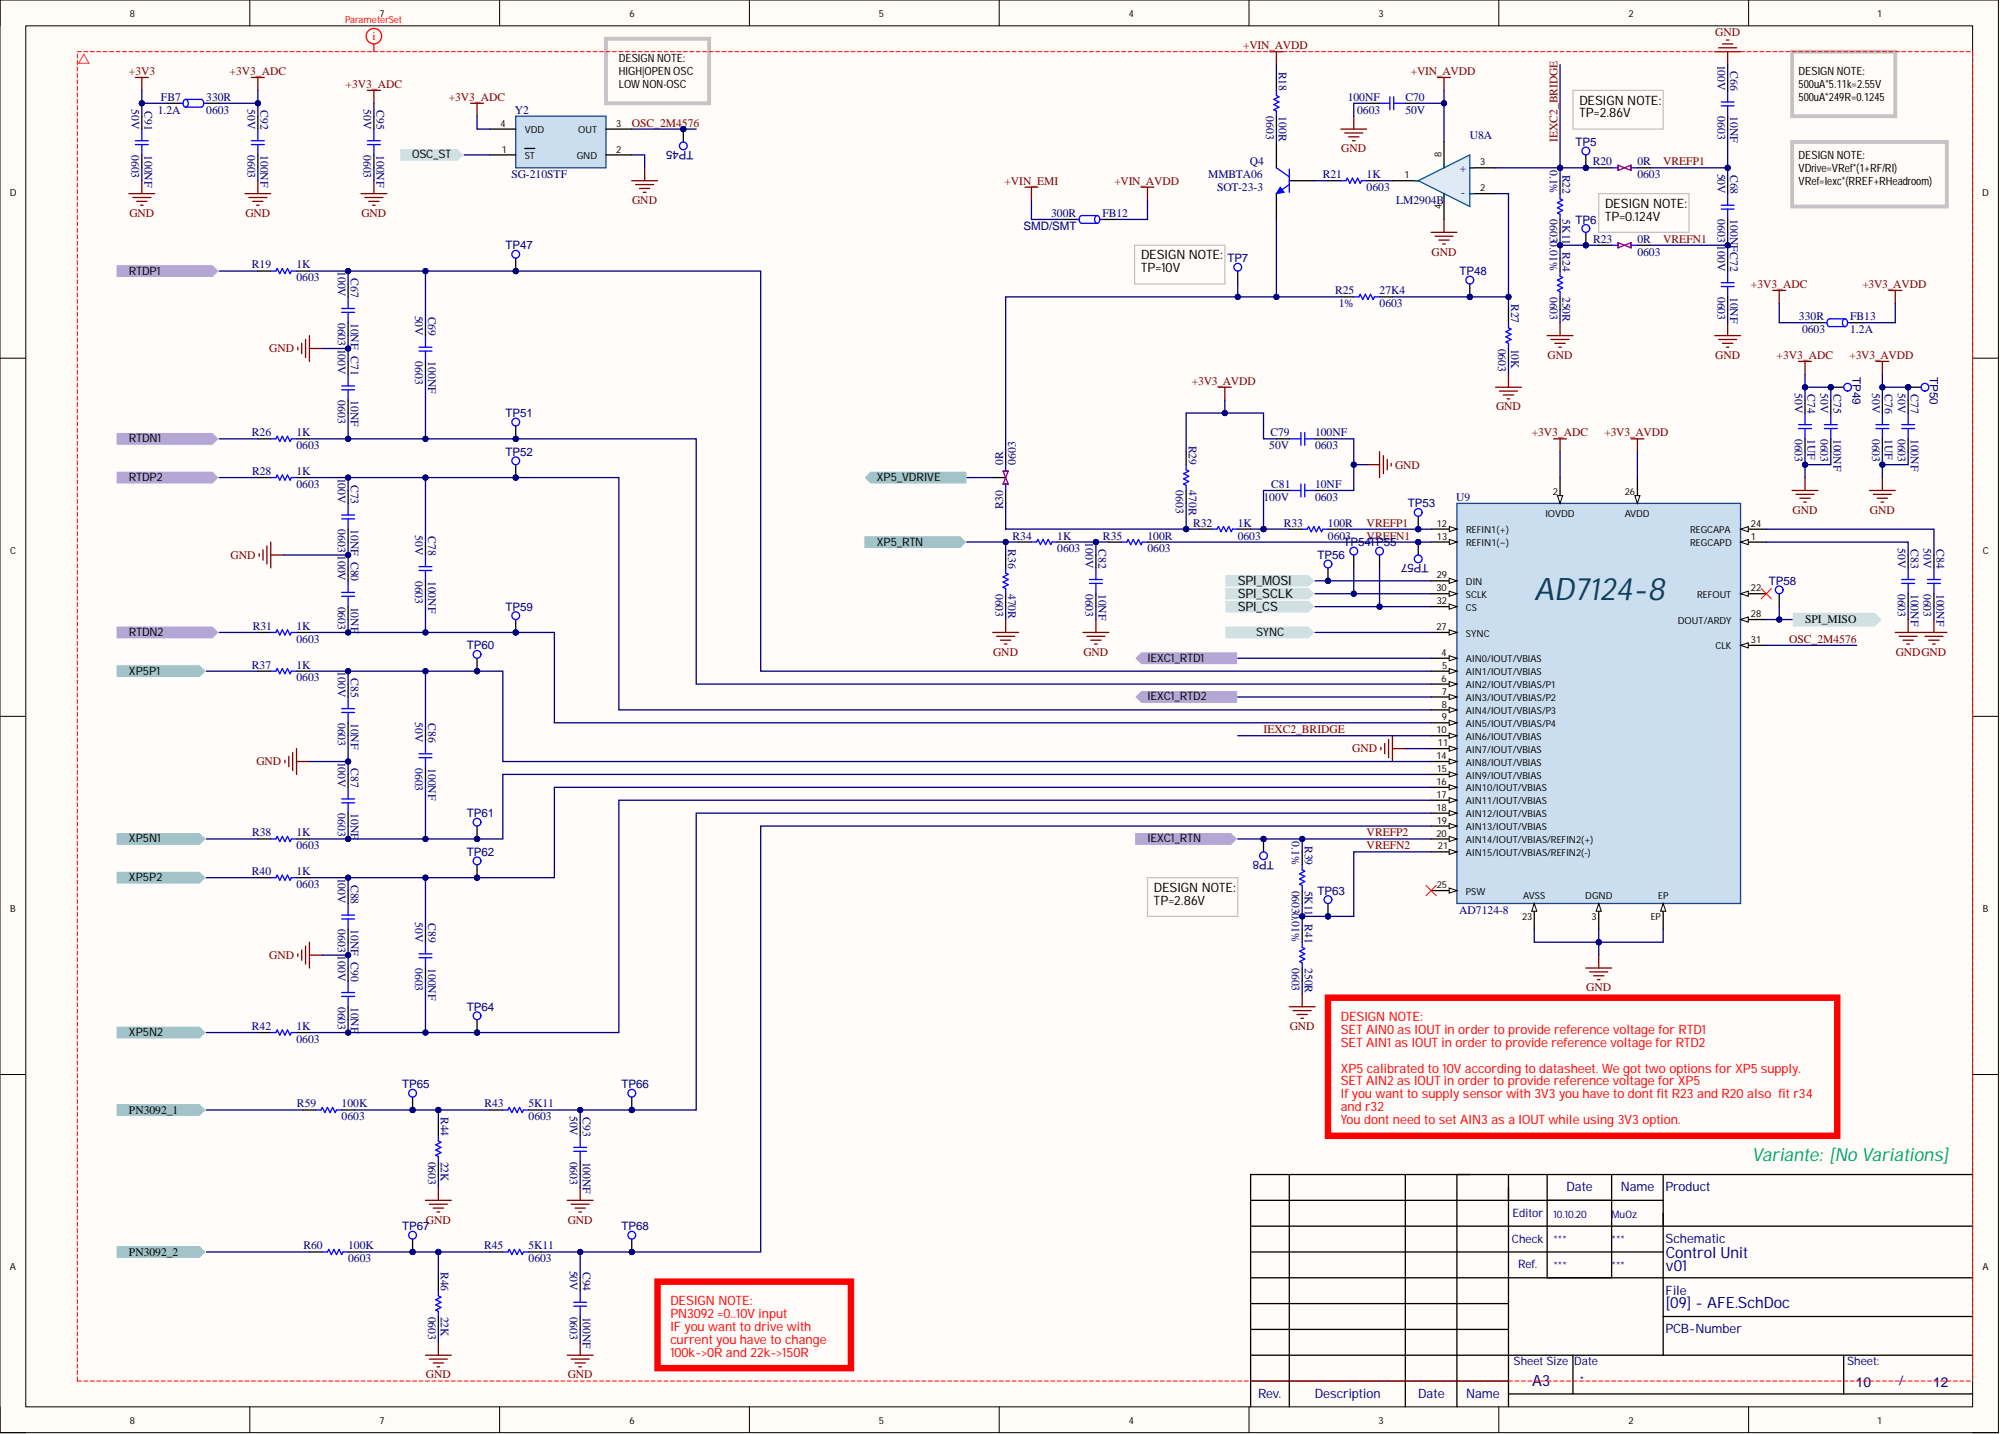
[picture p10: page 10]

DESIGN NOTE:
VDrive=VRef*(1+RF/RI)
VRef=Iexc*(RREF+RHeadroom)

AIN7/IOUT/VBIAS 11
AIN8/IOUT/VBIAS 14
AIN9/IOUT/VBIAS 15
AIN10/IOUT/VBIAS 16
AIN11/IOUT/VBIAS 17

TP61 | | AIN12/IOUT/VBIAS 18

AIN13/IOUT/VBIAS 19

VREFP2 | AIN14/IOUT/VBIAS/REFIN2(+) 20

TP62 | | | VREFN2 | AIN15/IOUT/VBIAS/REFIN2(-) 21

TP63 | PSW 25

DESIGN NOTE: SET AIN0 as IOUT in order to provide reference voltage for RTD1 SET AIN1 as IOUT in order to provide reference voltage for RTD2 XP5 calibrated to 10V according to datasheet. We got two options for XP5 supply. SET AIN2 as IOUT in order to provide reference voltage for XP5 If you want to supply sensor with 3V3 you have to dont fit R23 and R20 also fit r34 You dont need to set AIN3 as a IOUT while using 3V3 option.

and r32

PN3092 =0..10V input
IF you want to drive with
current you have to change
100k->0R and 22k->150R

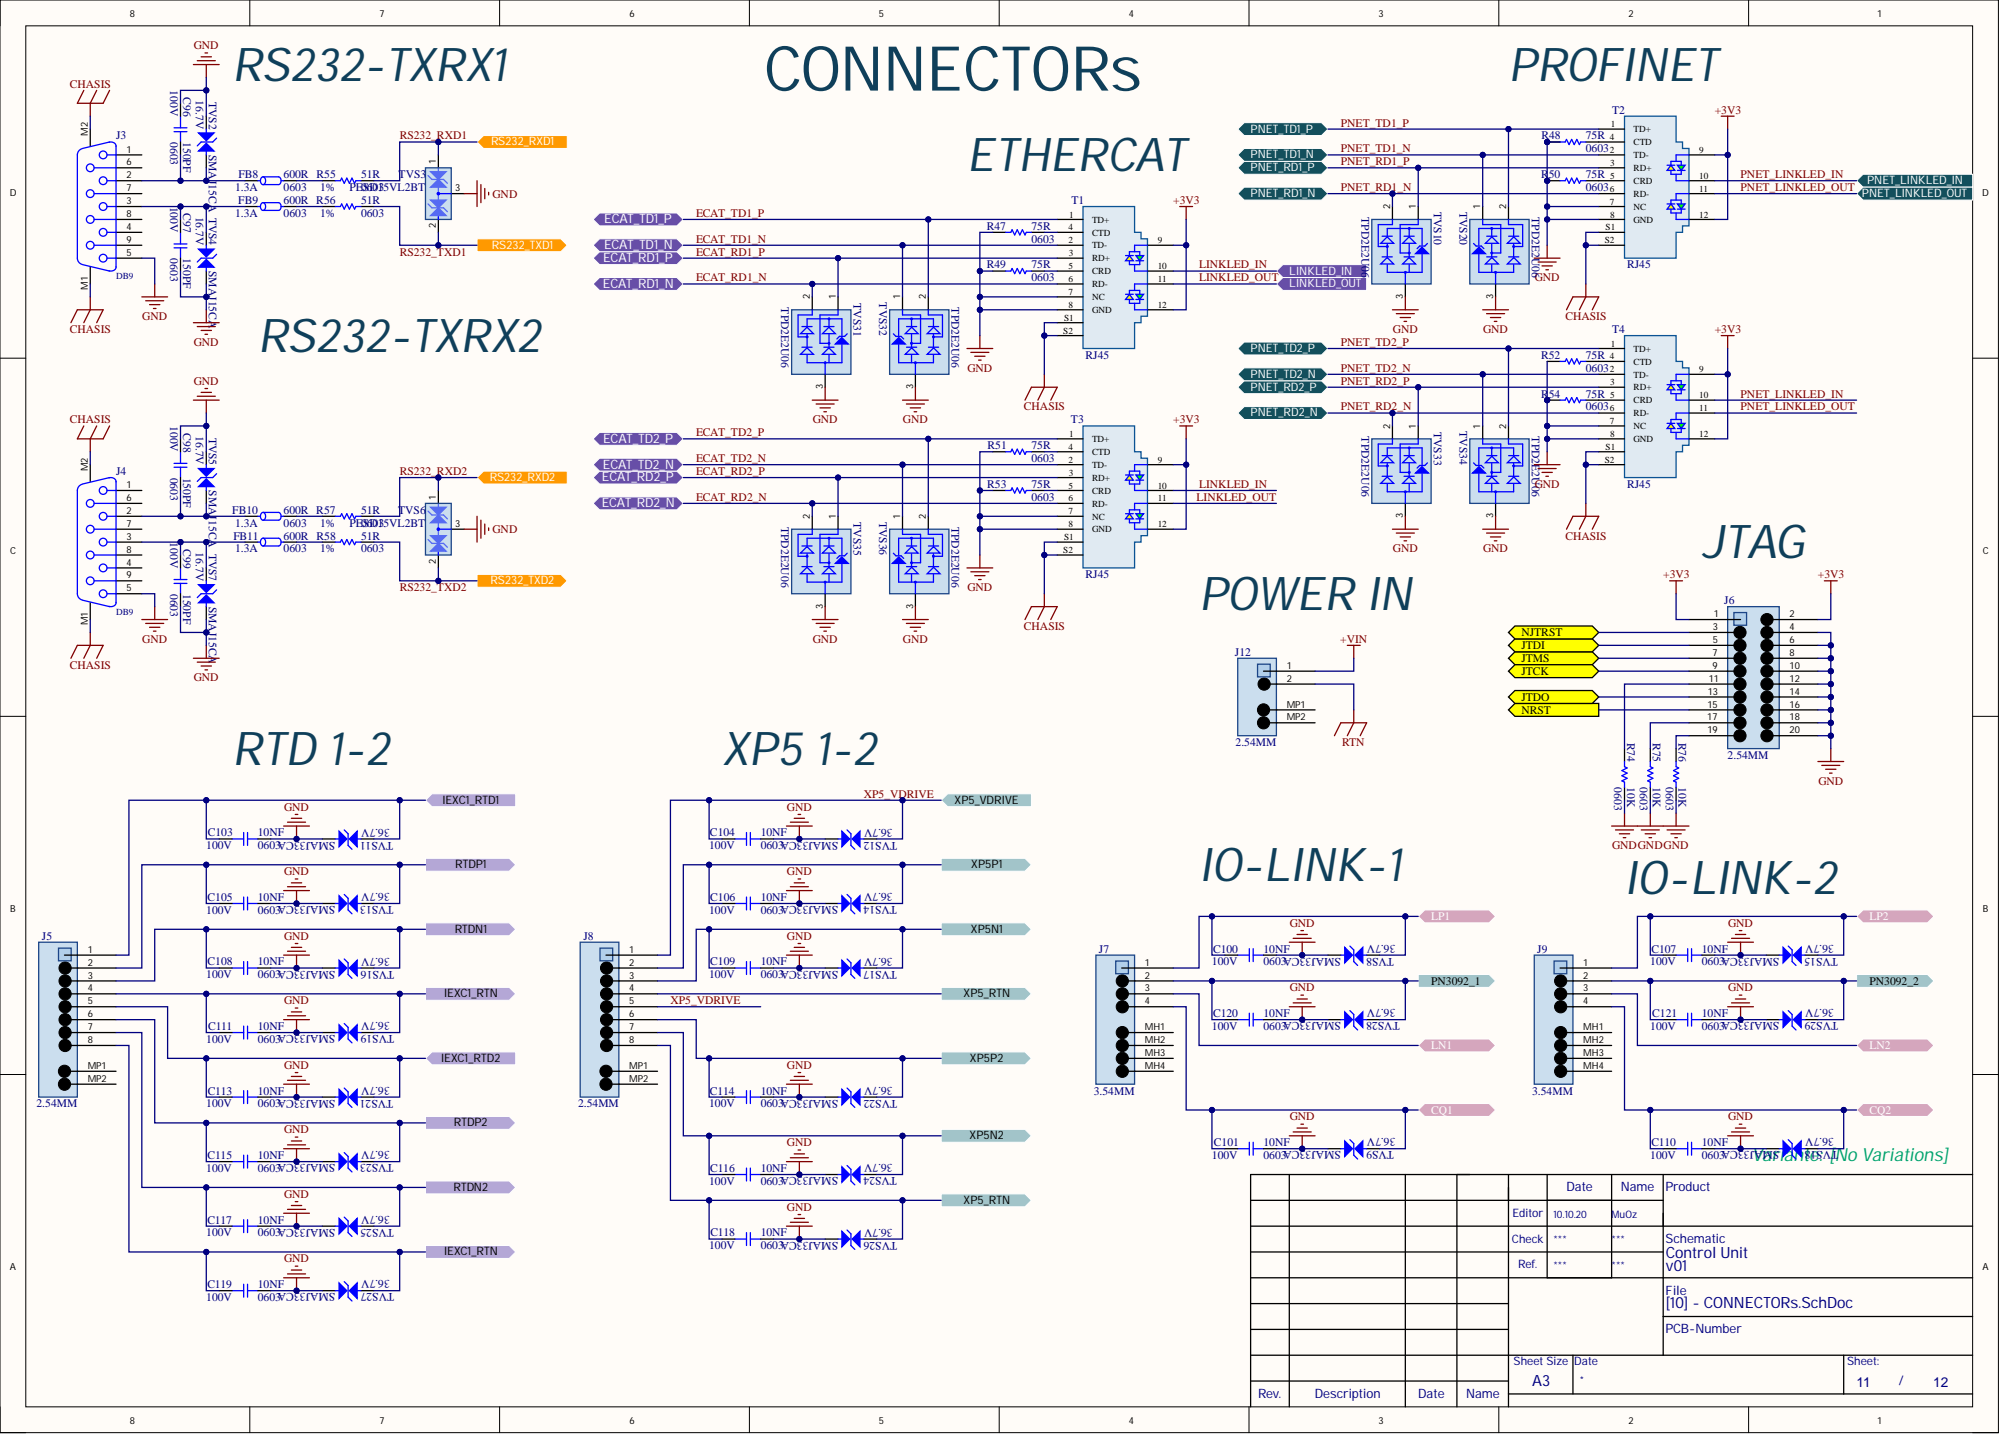
[picture p11: page 11]

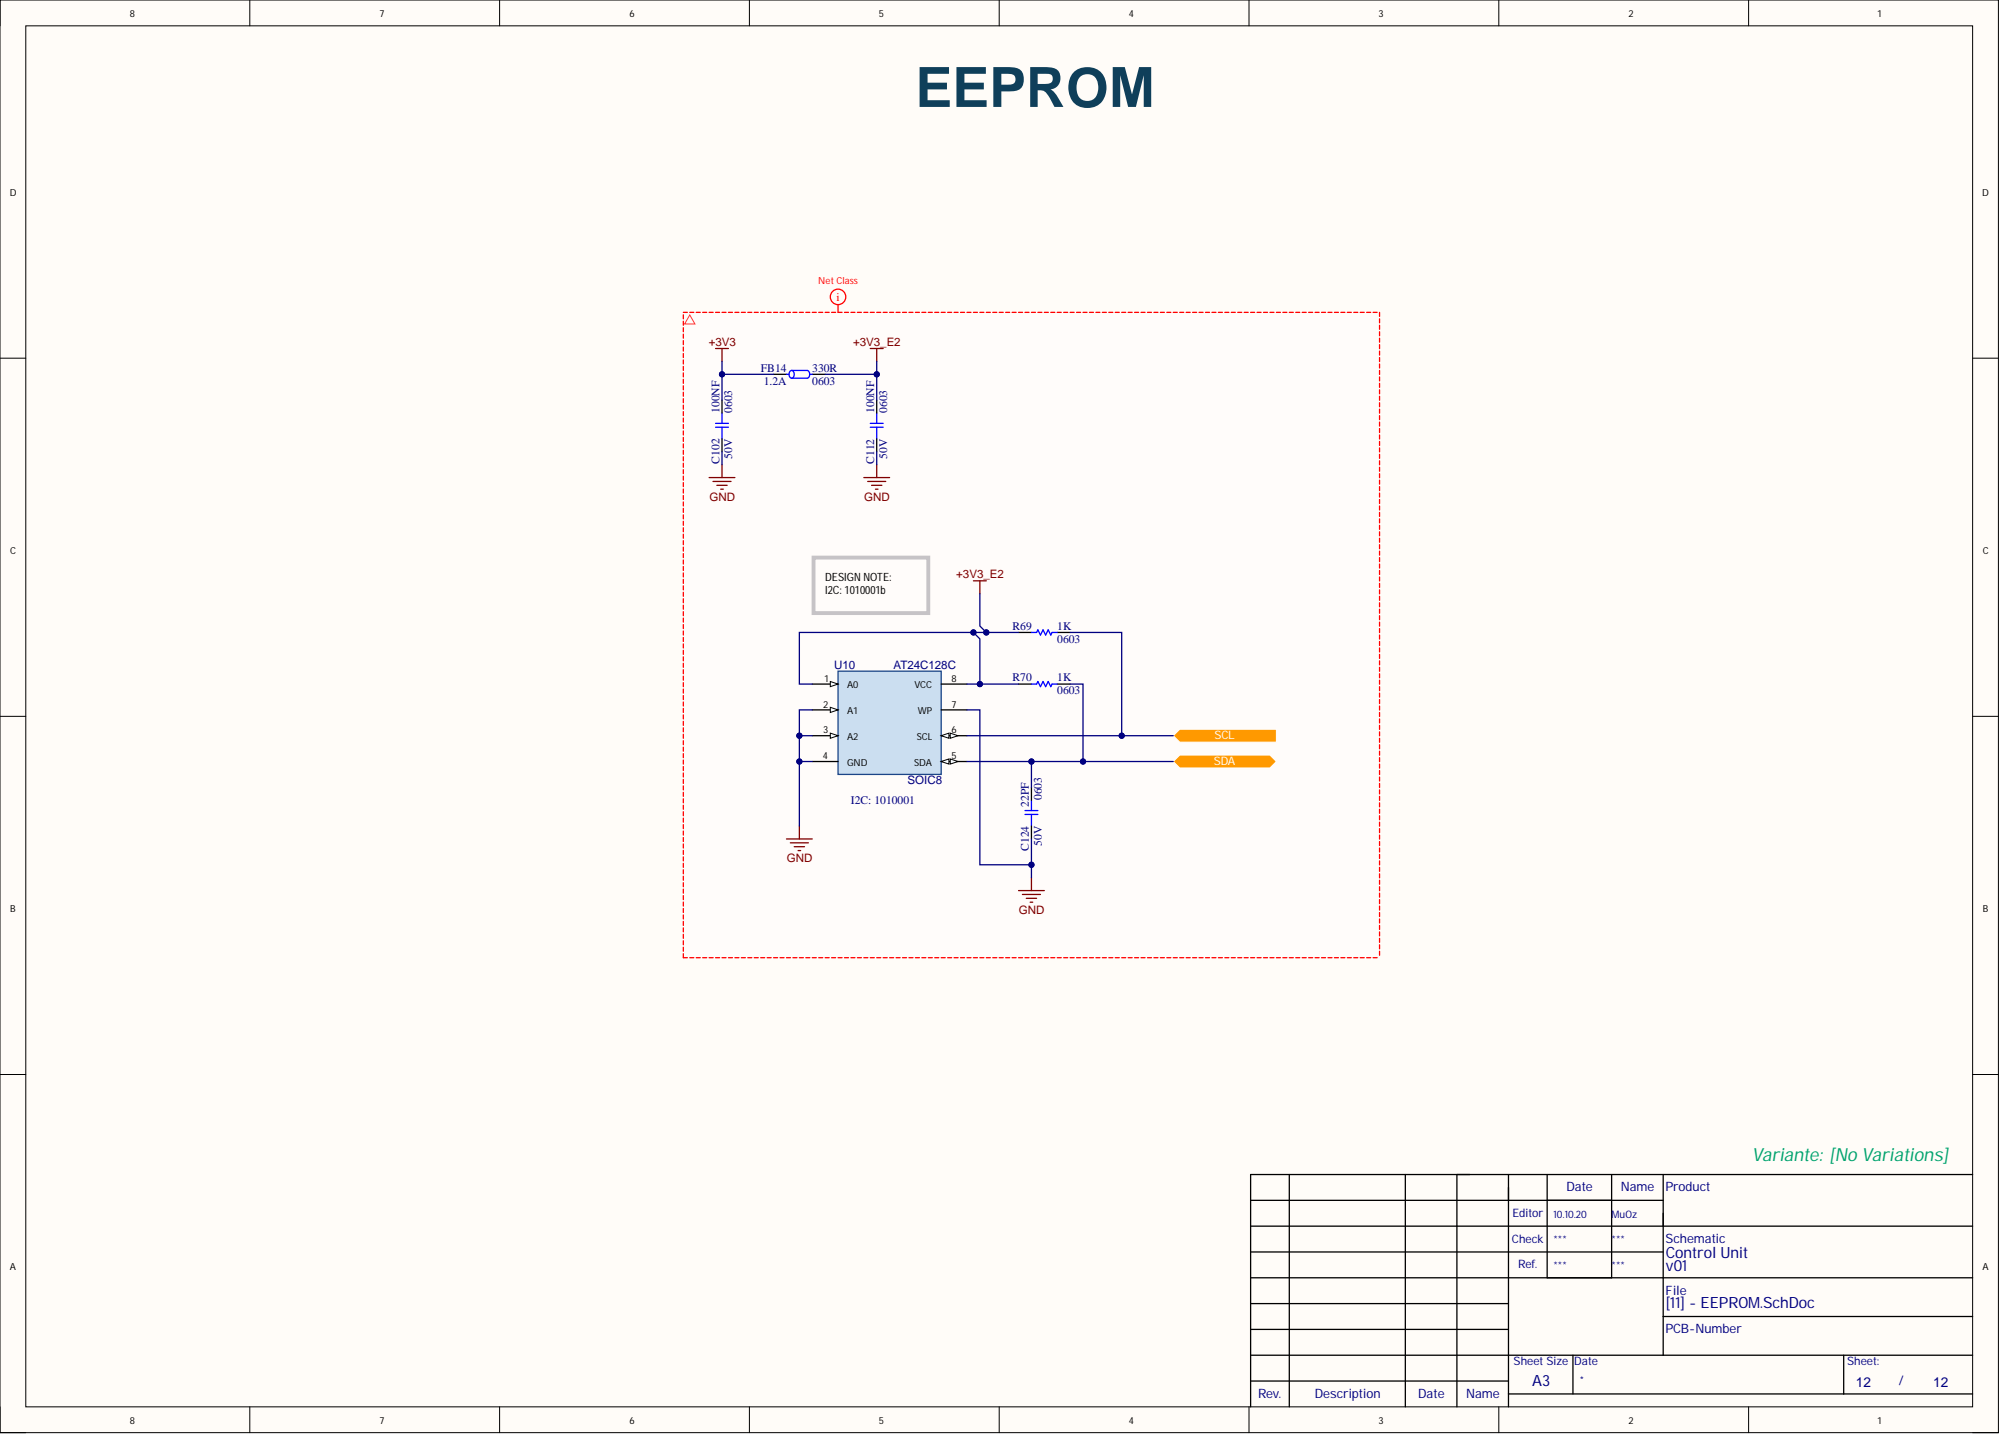
[picture p12: page 12]
