mstfozkan/System-Control-Unit/ELEKTRONIK/SCHEMATIC/PumpSystem - Block Diagram.pdf

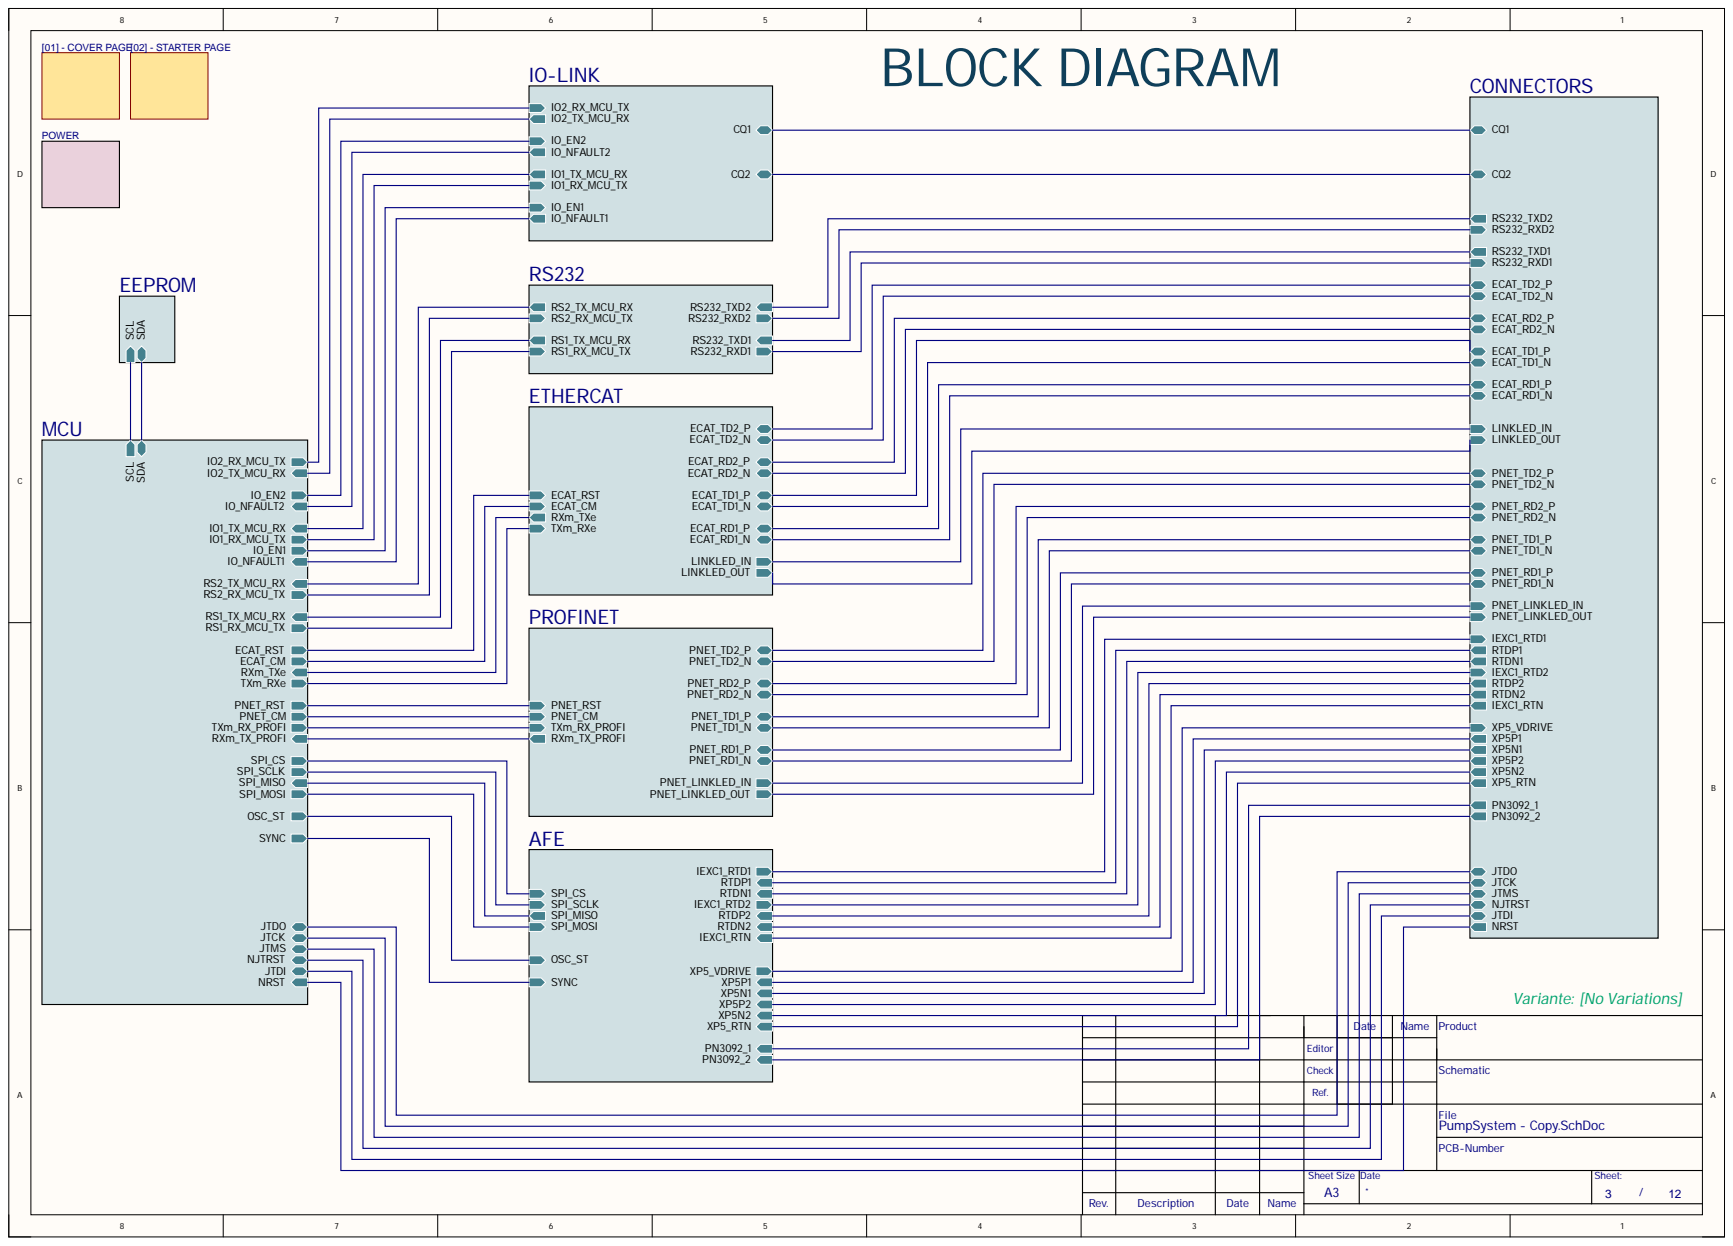
[picture p13: page 1]

[01] - COVER PAGE[02] - STARTER PAGE

PROFINET

PNET_TD2_P PNET_TD2_N PNET_RD2_P PNET_RD2_N PNET_RST PNET_CM PNET_TD1_P TXm_RX_PROFI PNET_TD1_N RXm_TX_PROFI PNET_RD1_P PNET_RD1_N PNET_LINKLED_IN PNET_LINKLED_OUT

AFE

Editor

Check

Ref.
