mstfozkan/System-Control-Unit/DOKUMANLAR/dimension.PDF

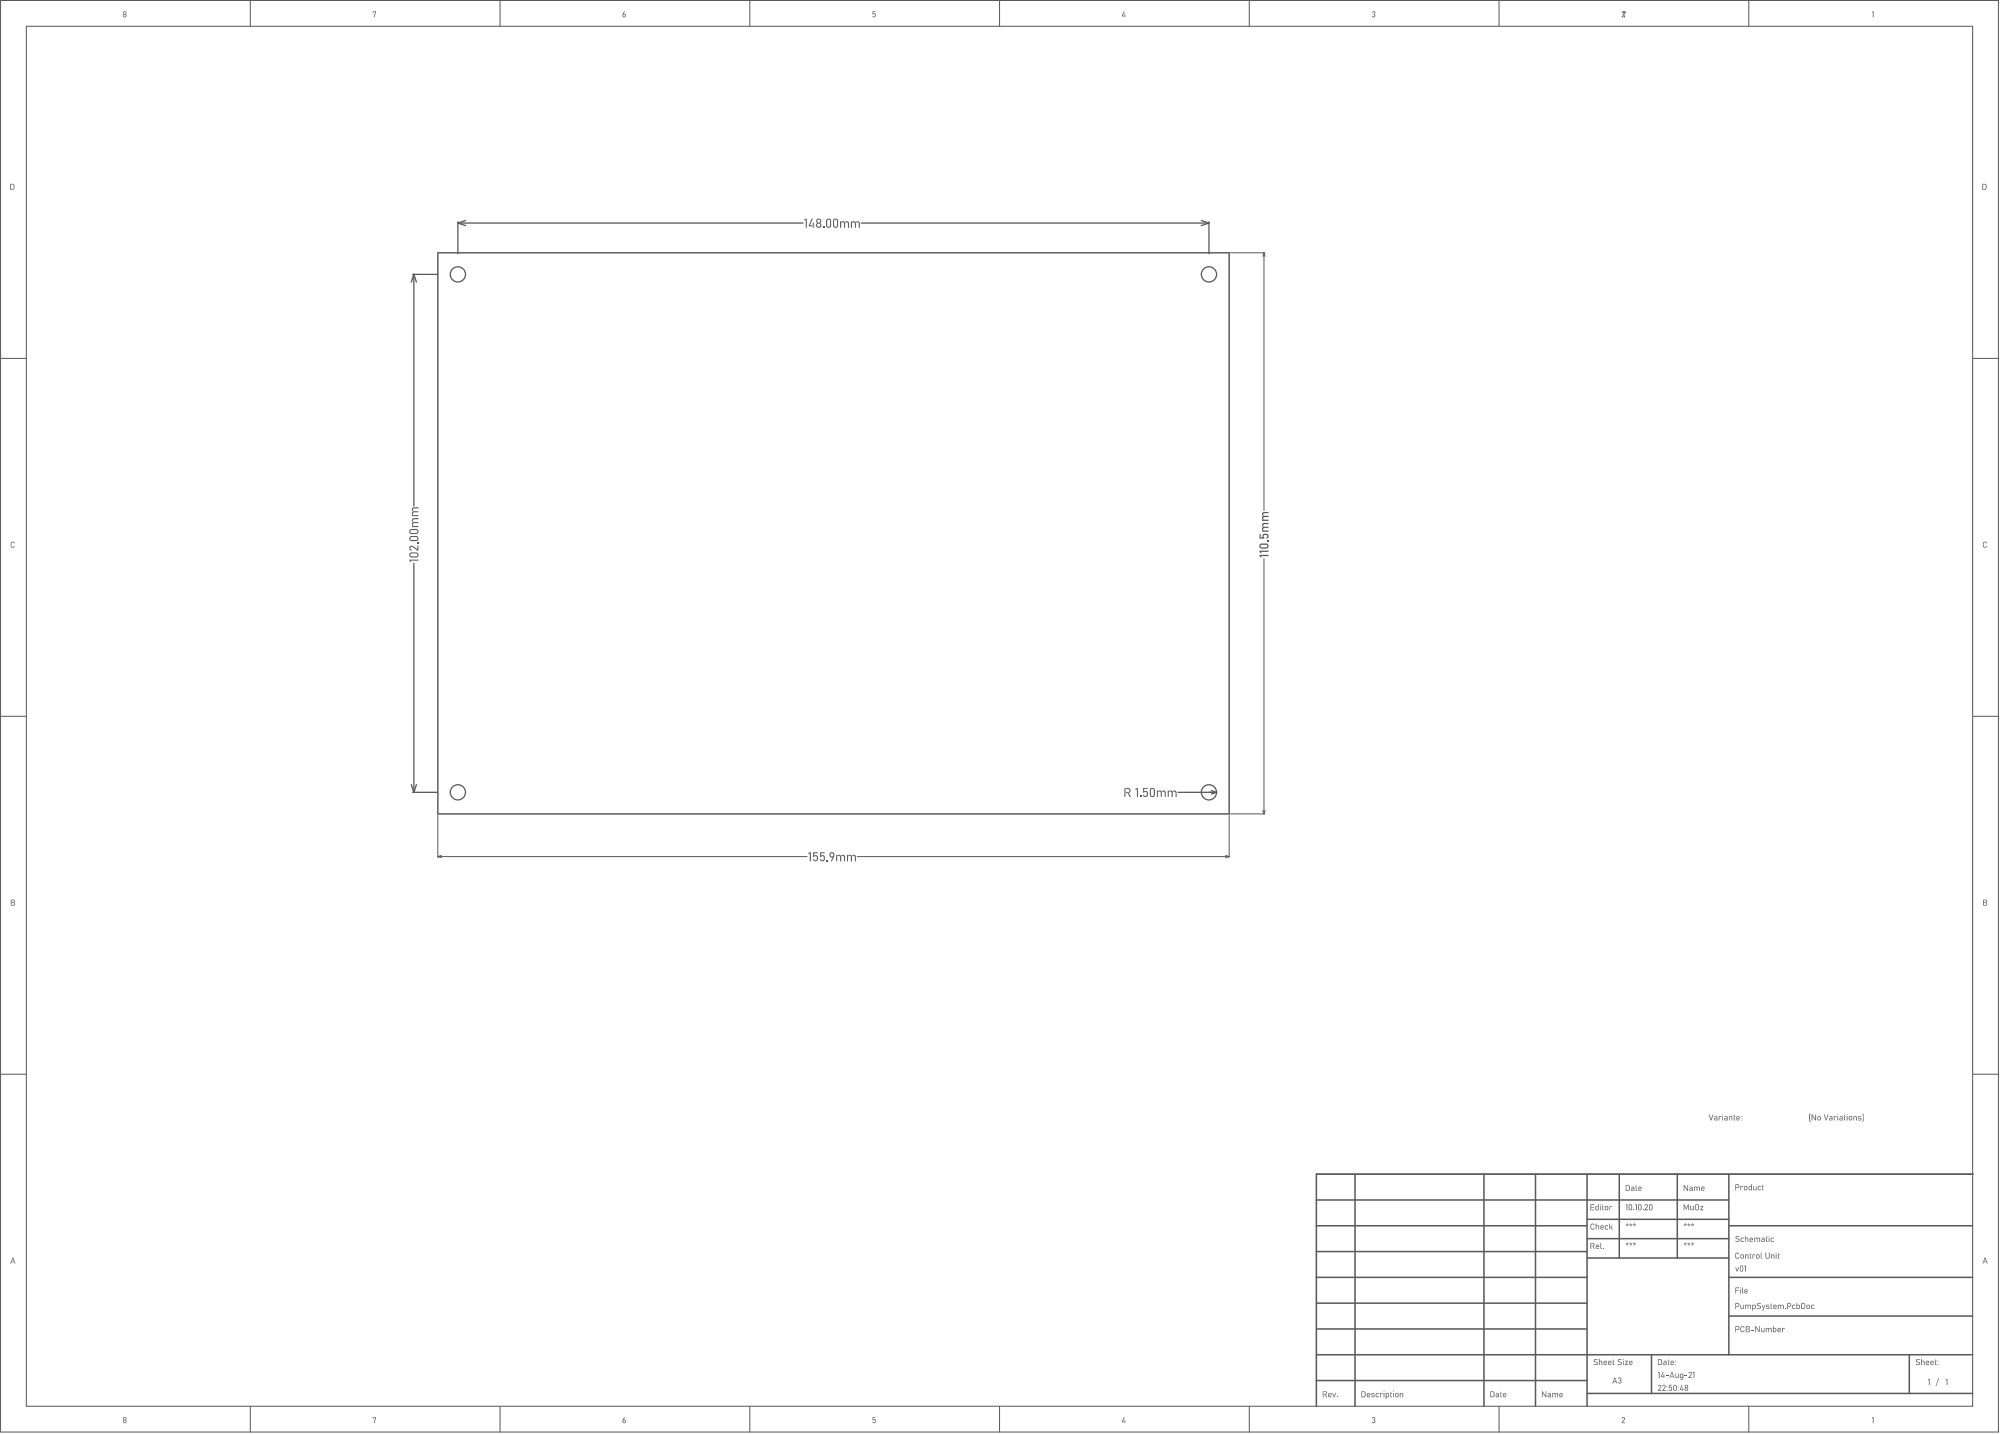
[picture p14: page 1]
