mstfozkan/System-Control-Unit/DOKUMANLAR/komponent.PDF

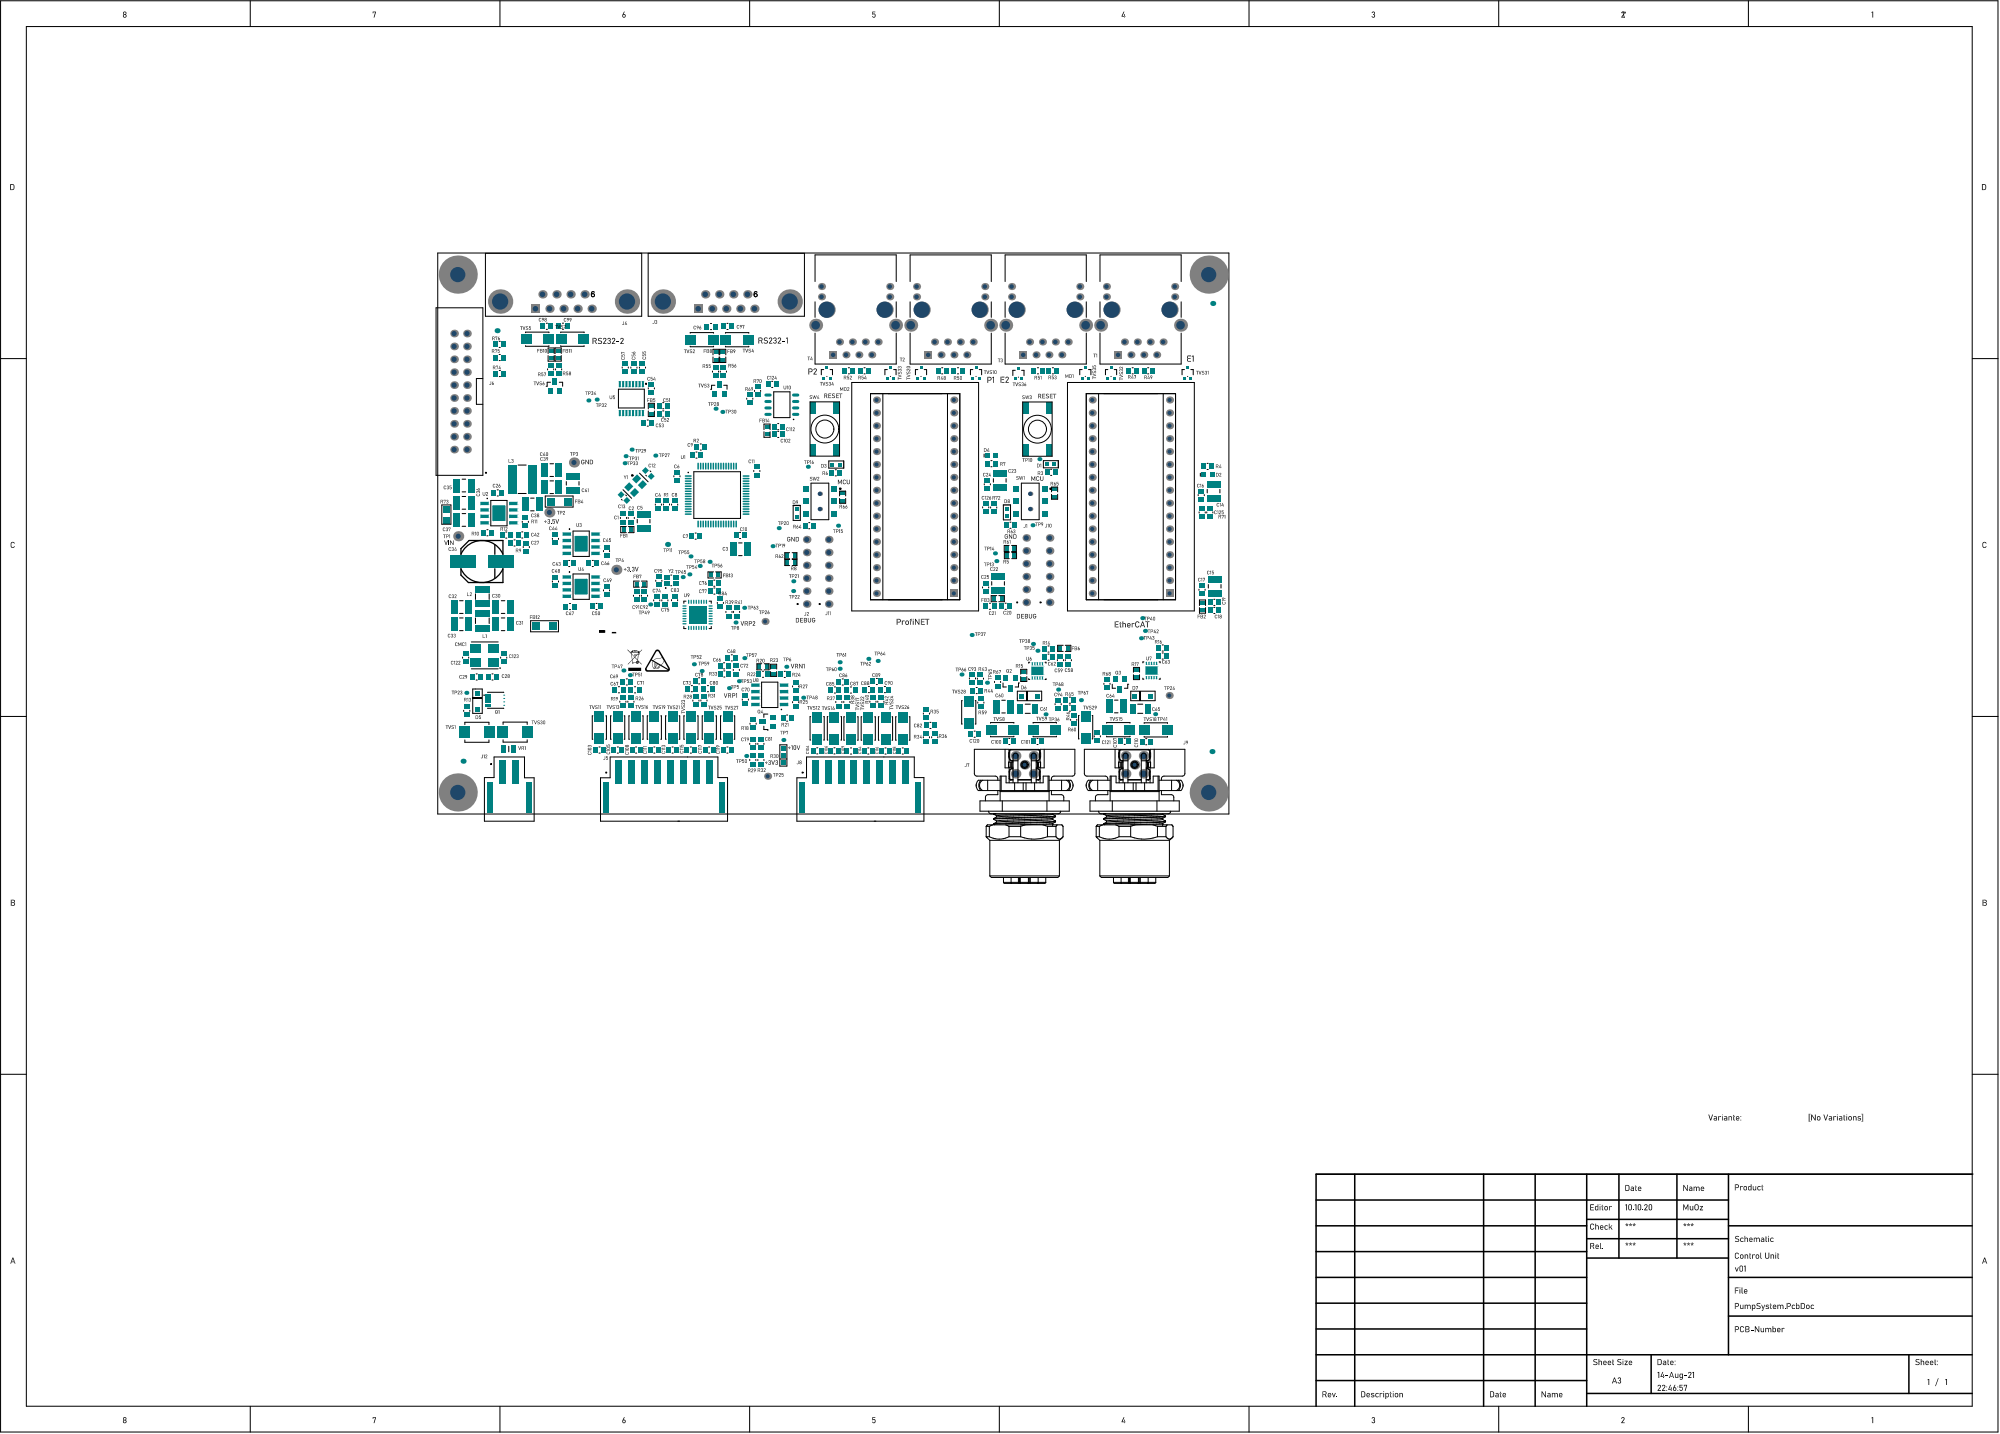
[picture p15: page 1]

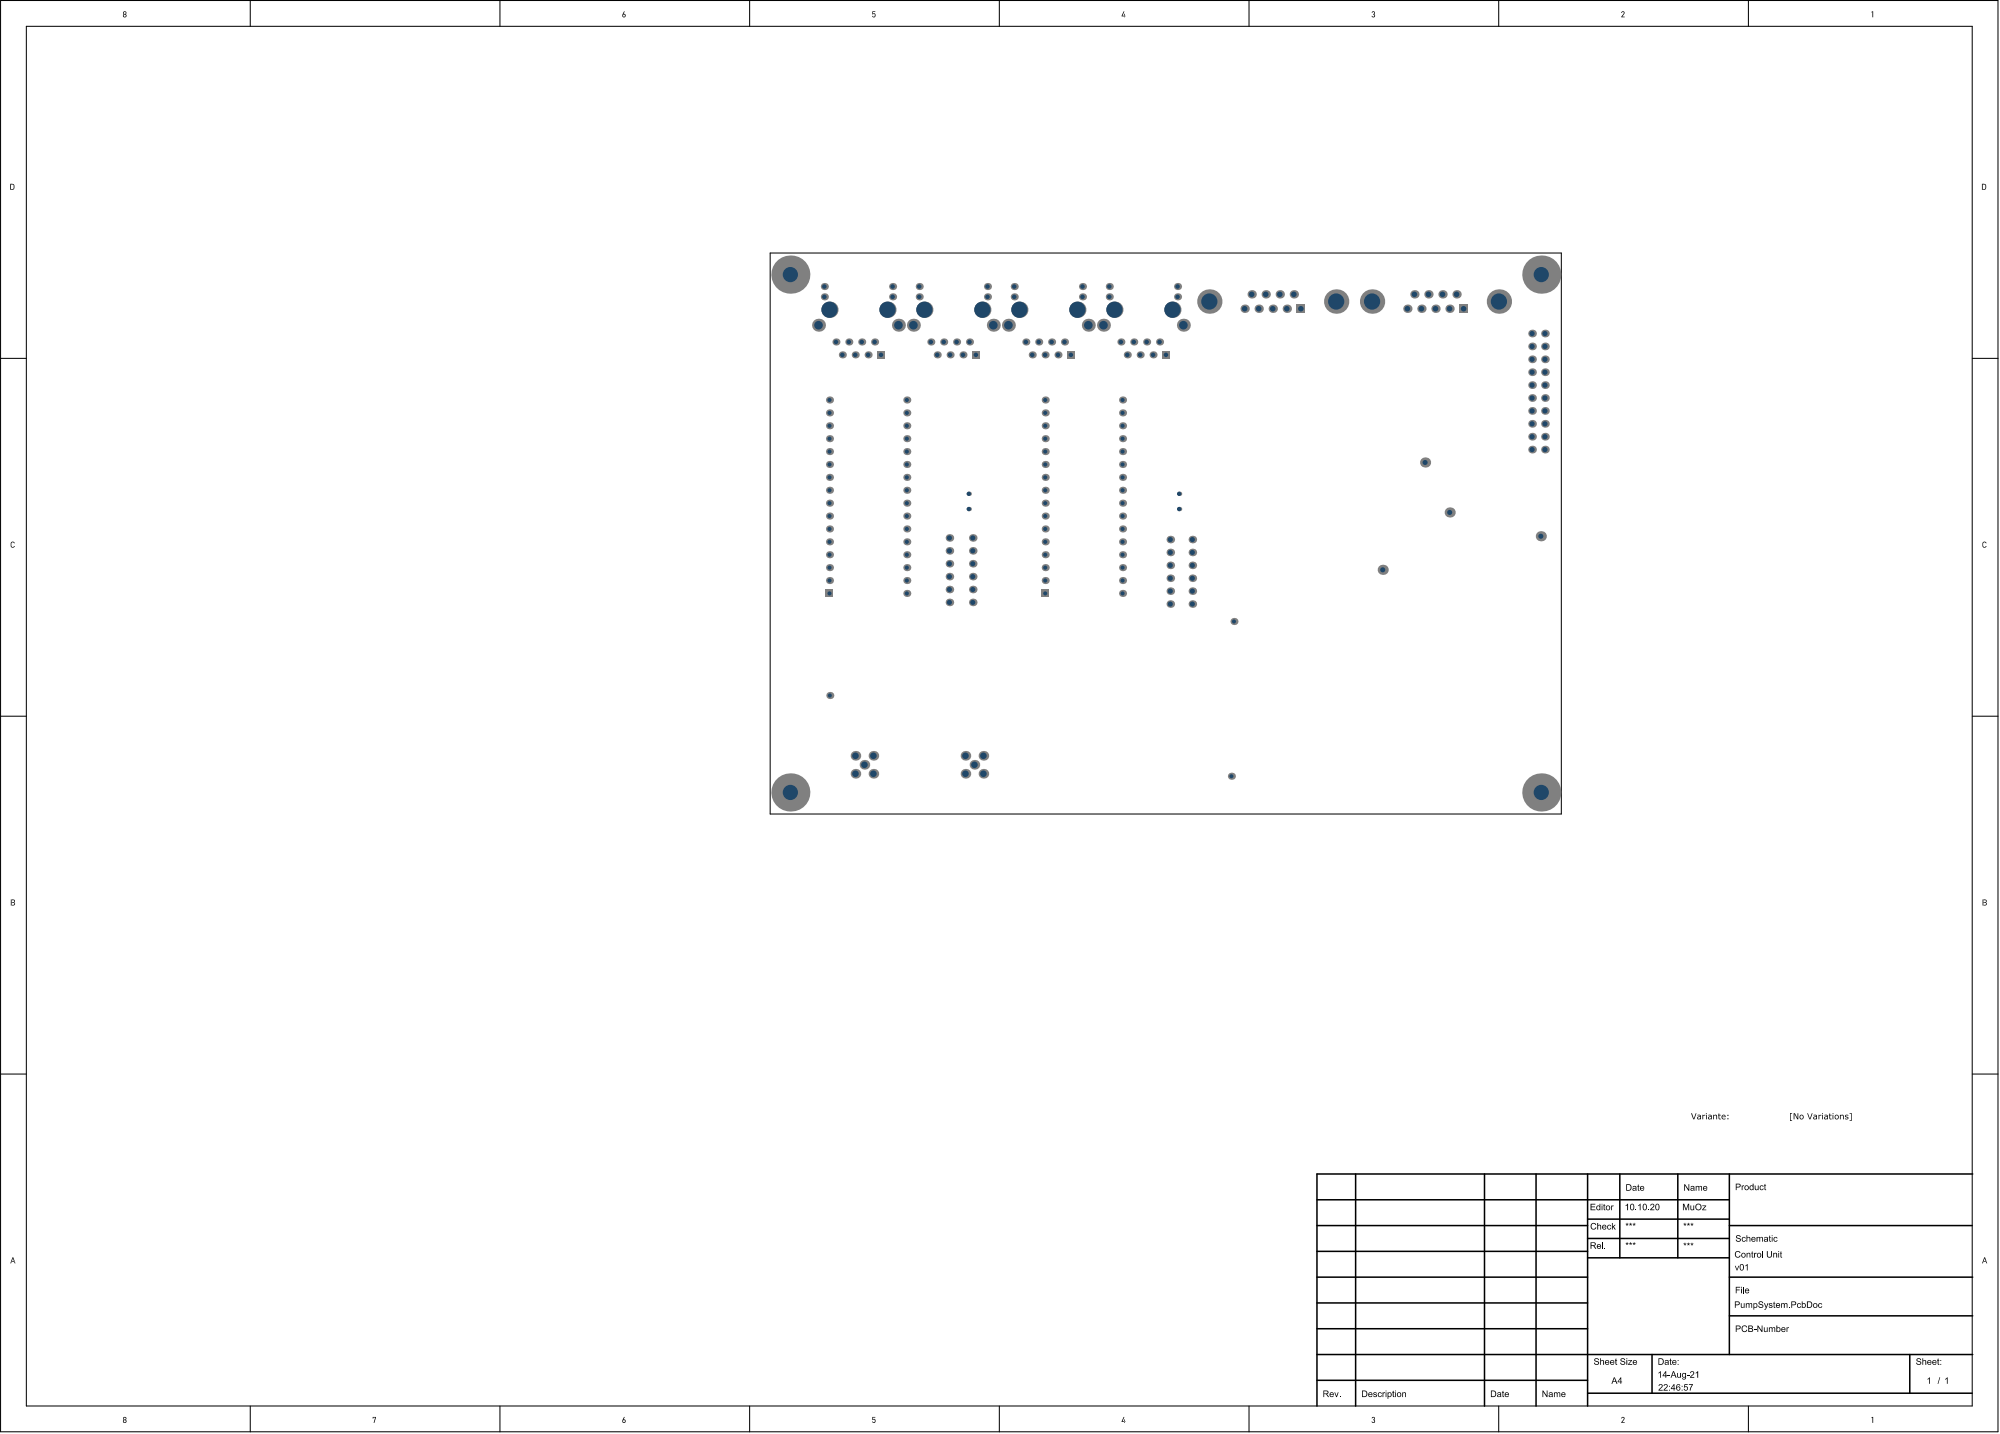
[picture p16: page 2]
