mstfozkan/System-Control-Unit/DOKUMANLAR/Layout.PDF

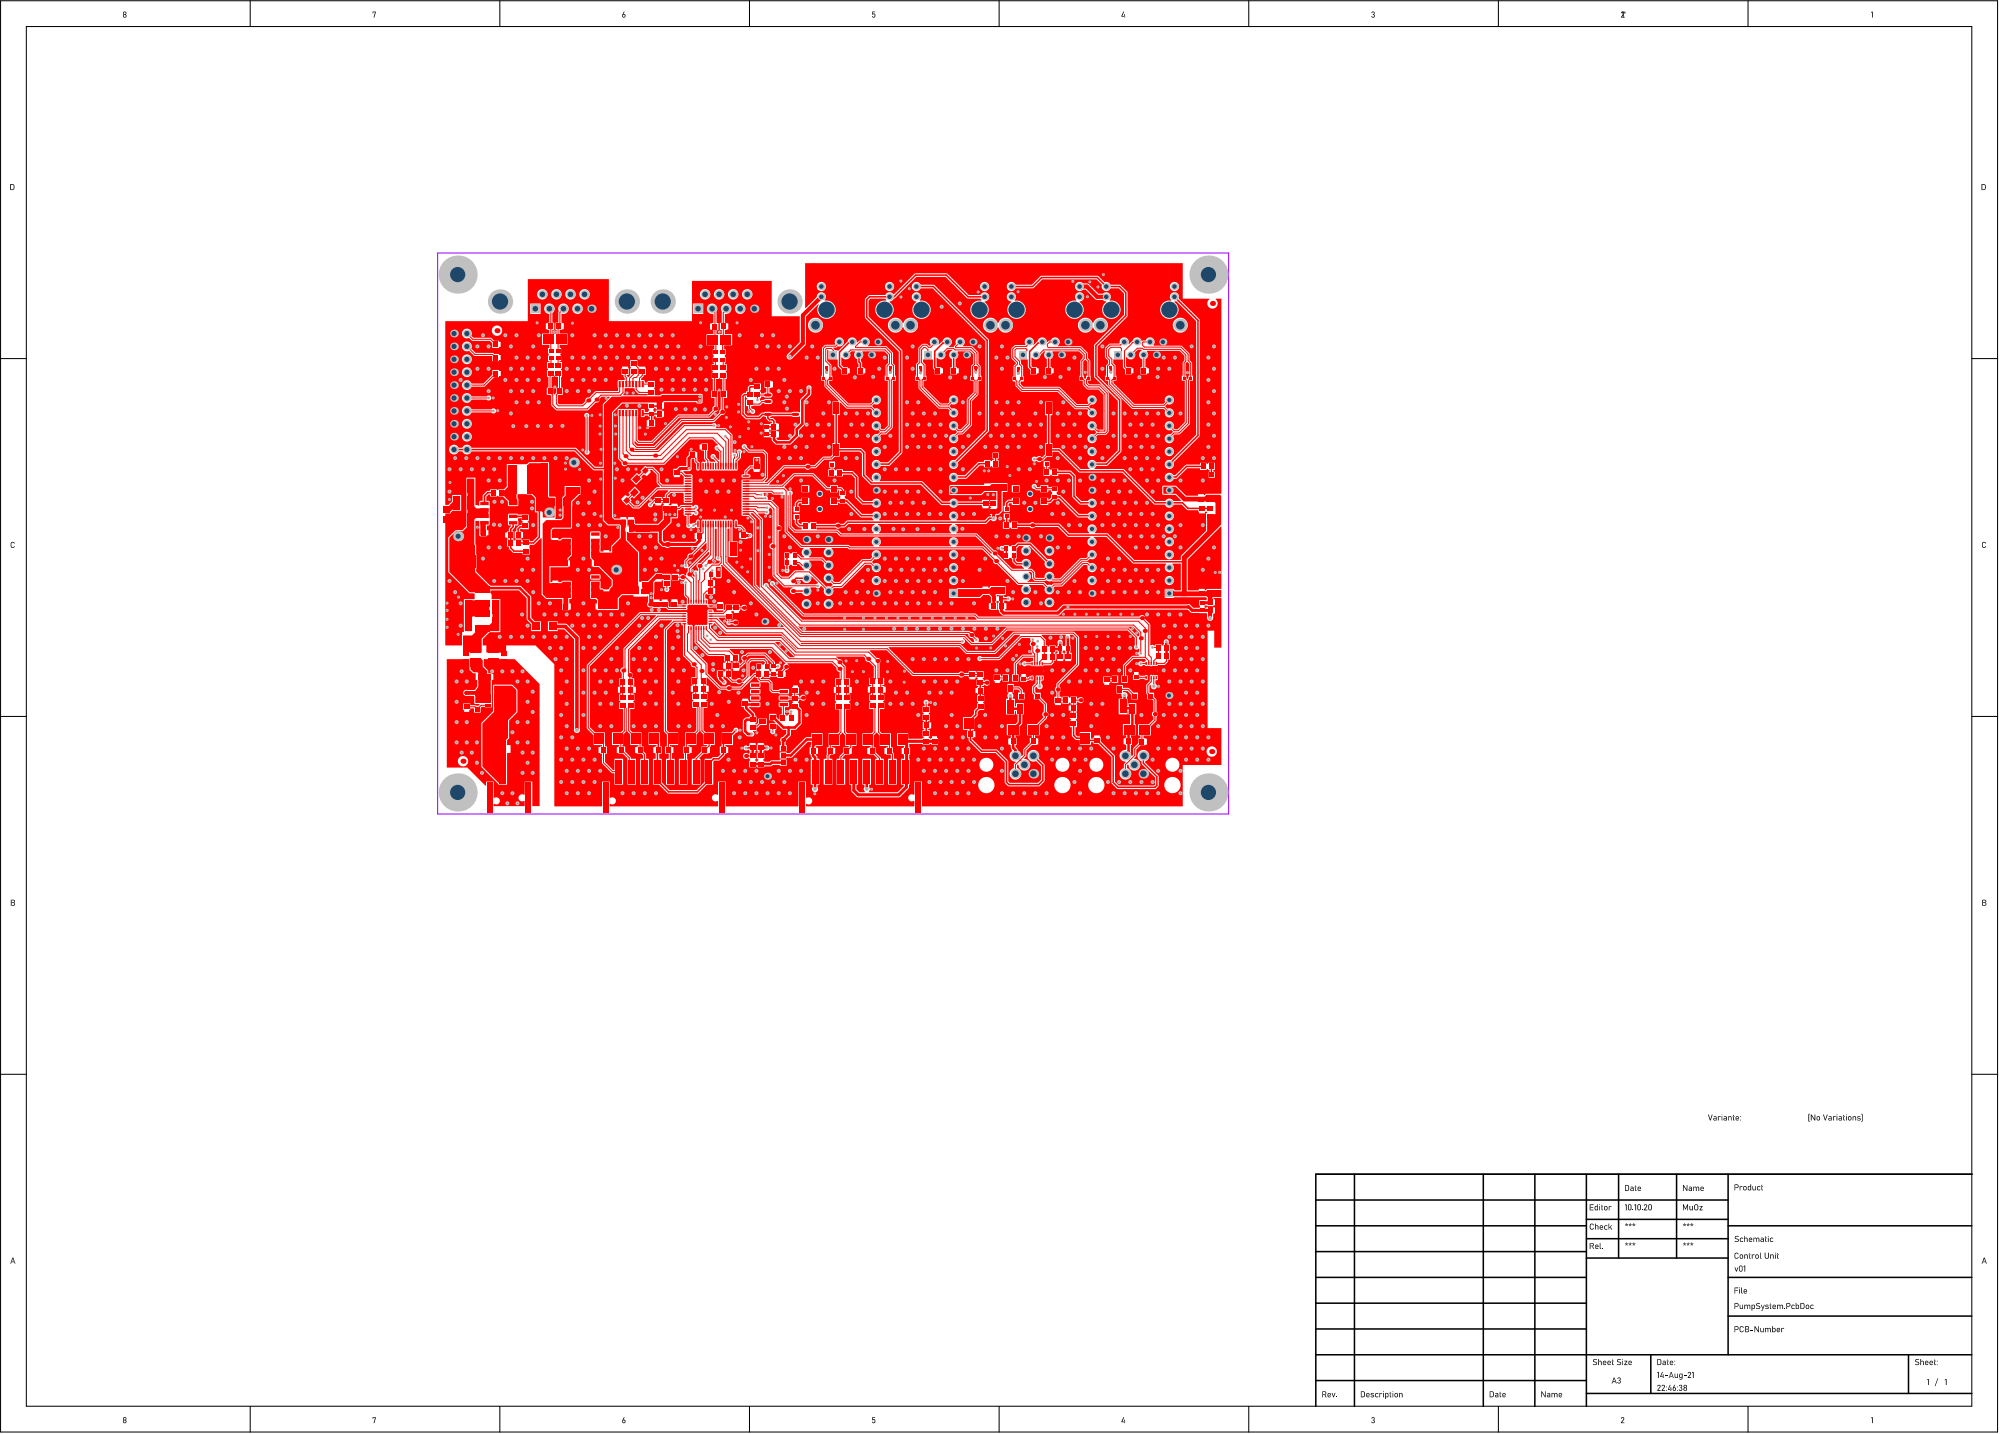
[picture p17: page 1]

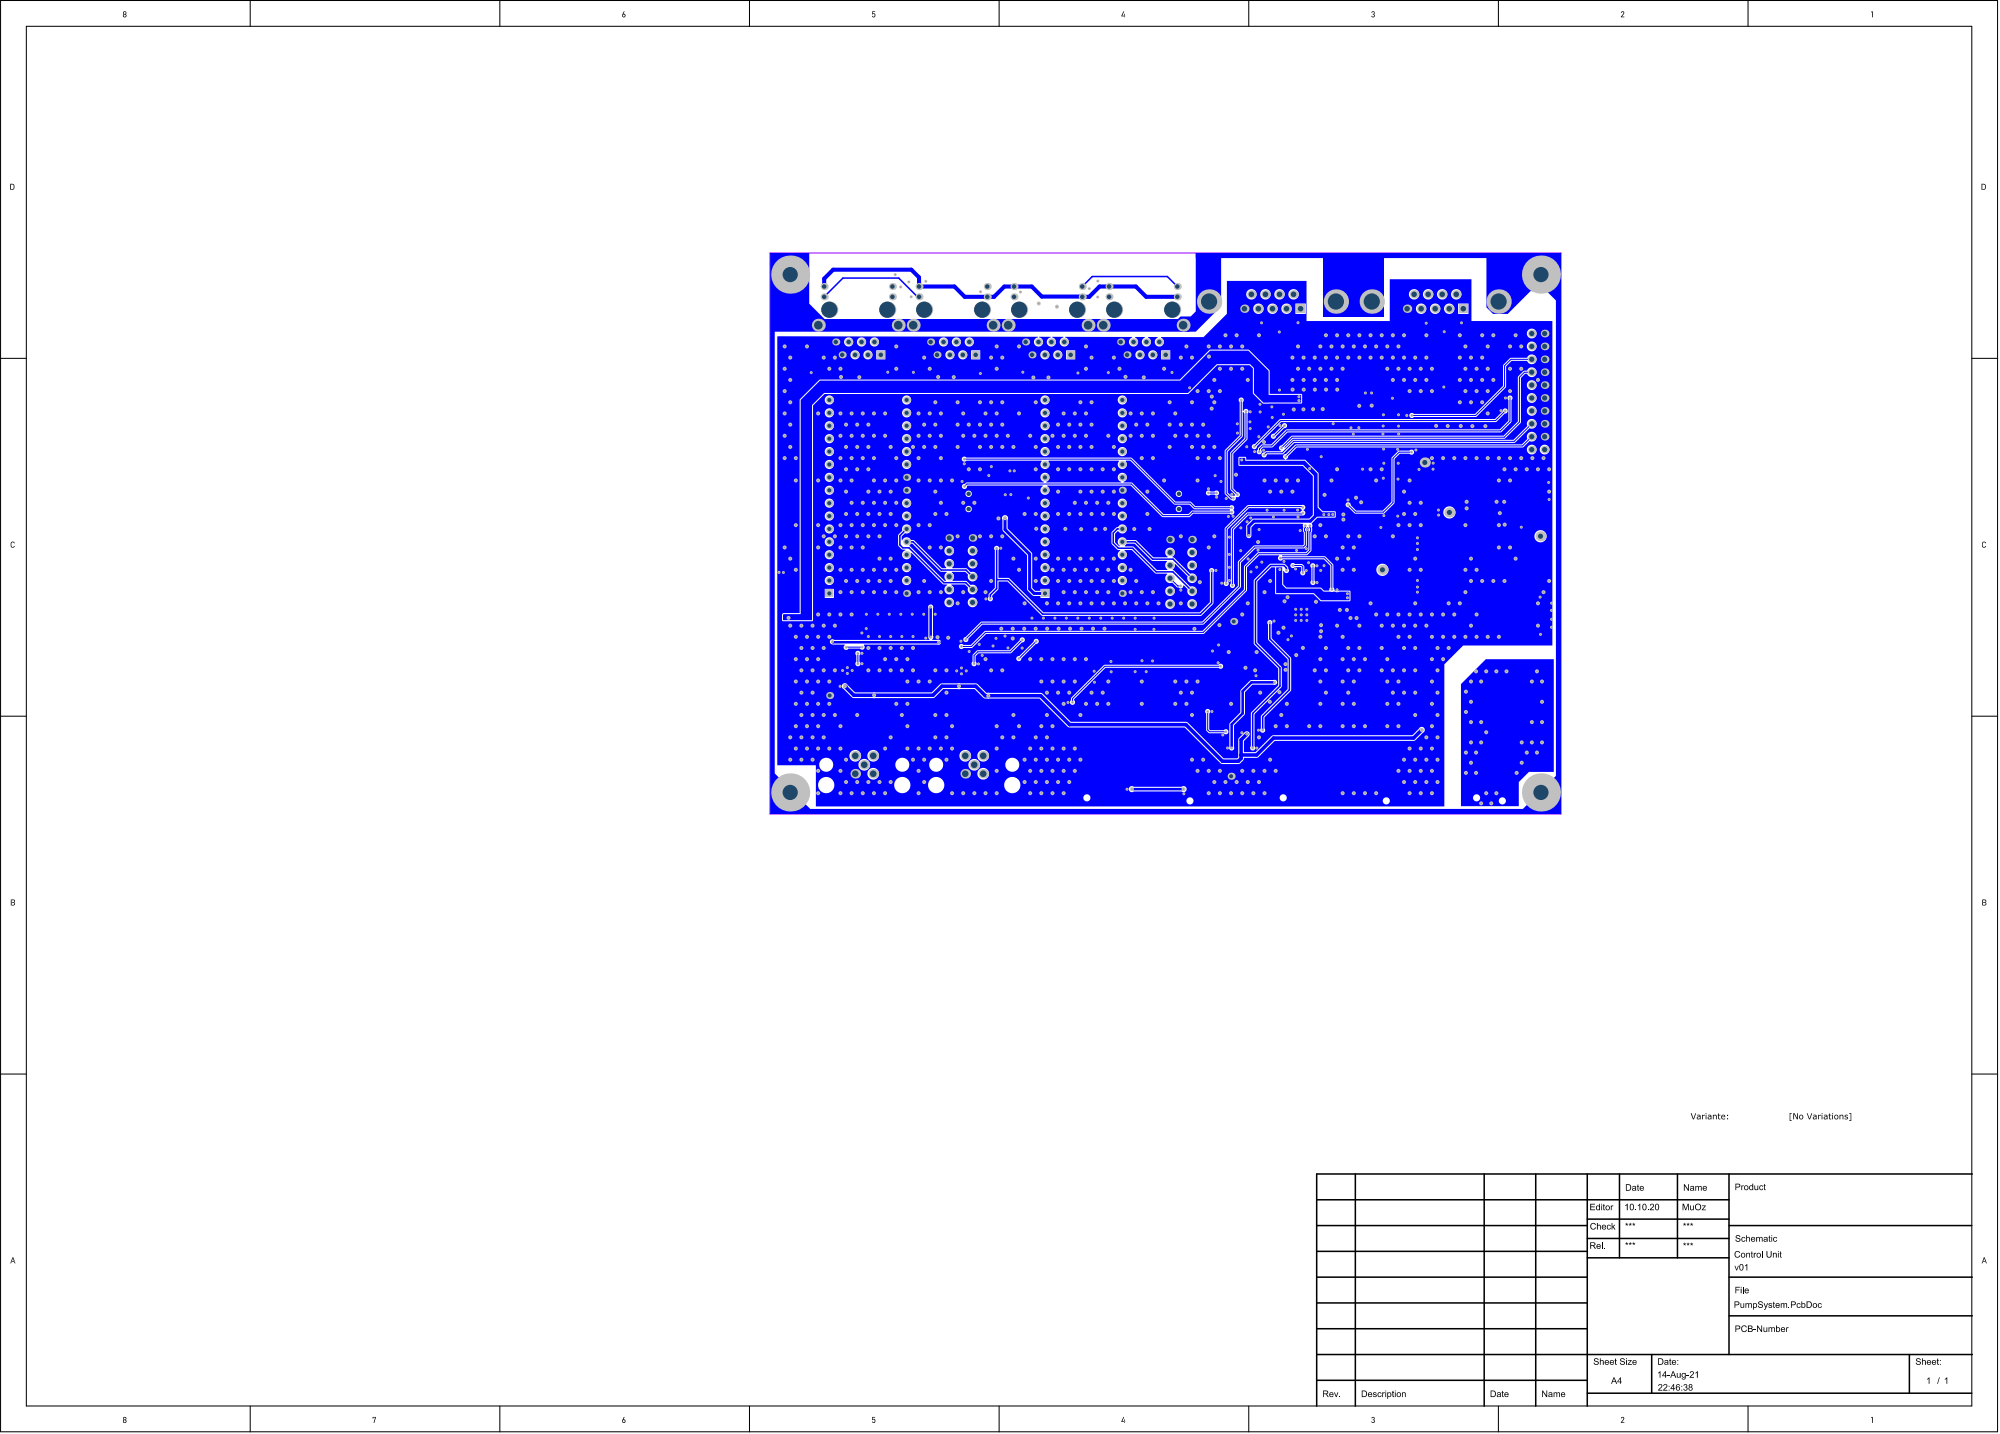
[picture p18: page 2]
