mstfozkan/System-Control-Unit/(list of files, drawings)

Other design files:
ELEKTRONIK/PCB PROJECT/PumpSystem.PrjPCB
ELEKTRONIK/SCHEMATIC/[01] - COVER PAGE.SchDoc
ELEKTRONIK/SCHEMATIC/[02] - STARTER PAGE.SchDoc
ELEKTRONIK/SCHEMATIC/[03] - MCU.SchDoc
ELEKTRONIK/SCHEMATIC/[04] - ETHERCAT.SchDoc
ELEKTRONIK/SCHEMATIC/[05] - PROFINET.SchDoc
ELEKTRONIK/SCHEMATIC/[06] - POWER.SchDoc
ELEKTRONIK/SCHEMATIC/[07] - RS232.SchDoc
ELEKTRONIK/SCHEMATIC/[08] - IO-LINK.SchDoc
ELEKTRONIK/SCHEMATIC/[09] - AFE.SchDoc
ELEKTRONIK/SCHEMATIC/[10] - CONNECTORs.SchDoc
ELEKTRONIK/SCHEMATIC/[11] - EEPROM.SchDoc
ELEKTRONIK/SCHEMATIC/PumpSystem - Copy.SchDoc
ELEKTRONIK/SCHEMATIC/PumpSystem.SchDoc
