mstfozkan/System-Control-Unit/(commit log)

2021-09-10 ignore update
    [PumpSystem.PrjPCB, [03] - MCU.SchDoc, [04] - ETHERCAT.SchDoc, [05] - PROFINET.SchDoc, [06] - POWER.SchDoc, [07] - RS232.SchDoc, [09] - AFE.SchDoc, [10] - CONNECTORs.SchDoc]
2021-09-10 Update [08] - IO-LINK.SchDoc
    [[08] - IO-LINK.SchDoc]
